mar0x/midi_router/doc/midi_router-bom.xlsx

Sheet: x4
id | q | ref | desc | size | Vendor |  | Order info
 |  |  |  |  | URL | code | # | date | price | count | shipping | cost | cost per item
Top board
15 pF | 2 | C11 C12 | Кер.ЧИП конд. 15 пФ, C0G, 50В, 5% | 0805 | CC0805JRNPO9BN150 (https://www.terraelectronica.ru/product/355297) | #355297 (https://www.terraelectronica.ru/product/355297) | #07487681 (https://www.terraelectronica.ru/order/07487681) | 06.07.2021 | 0.54 | 20 |  | 10.80 | 1.08
0.1 uF | 8 | C1 C2 C3 C4 C5 C6 C7 C8 | Кер.ЧИП конд. 0.1 мкФ, X7R, 50В, 10% | 0805 | CL21B104KBCNNNC (https://www.terraelectronica.ru/product/817075) | #817075 (https://www.terraelectronica.ru/product/817075) | #07487681 (https://www.terraelectronica.ru/order/07487681) | 06.07.2021 | 0.47 | 100 |  | 47.00 | 3.76
BAS316 | 4 | D1 D2 D3 D4 | Диод импульсный | SOD-323 | BAS316 TP (https://www.terraelectronica.ru/product/663682) | #663682 (https://www.terraelectronica.ru/product/663682) | #07487681 (https://www.terraelectronica.ru/order/07487681) | 06.07.2021 | 0.88 | 40 |  | 35.20 | 3.52
L-13YD | 5 | D5 D7 D9 D11 D13 | Светодиод жёлтый |  | L-13YD (https://www.terraelectronica.ru/product/307869) | #307869 (https://www.terraelectronica.ru/product/307869) | #07487681 (https://www.terraelectronica.ru/order/07487681) | 06.07.2021 | 5.4 | 50 |  | 270.00 | 27.00
L-13GD | 5 | D6 D8 D10 D12 D14 | Светодиод зелёный |  | L-13GD (https://www.terraelectronica.ru/product/307956) | #307956 (https://www.terraelectronica.ru/product/307956) | #07671493 (https://www.terraelectronica.ru/order/07671493) | 08.11.2021 | 5 | 50 |  | 250.00 | 25.00
L-13ID | 1 | D15 | Светодиод красный |  | L-13ID (https://www.terraelectronica.ru/product/307856) | #307856 (https://www.terraelectronica.ru/product/307856) | #07487681 (https://www.terraelectronica.ru/order/07487681) | 06.07.2021 | 5.1 | 10 |  | 51.00 | 5.10
 | 1 | J1 | PinSocket 2x5 |  |  | #33022627806 (https://www.aliexpress.ru/item/33022627806.html) | #5010848944632510 (https://trade.aliexpress.ru/order_detail.htm?orderId=5010848944632510&orderSource=GlobalTrade) | 12.06.2021 | 19.392 | 10 | 300.49 | 494.41 | 49.44
DS1013-06SSiB1-B-0 | 1 | J2 | IDC Header 2x3 |  | BH-06 (https://www.chipdip.ru/product/idc-06ms-bh-06) | #9000058155 (https://www.chipdip.ru/product/idc-06ms-bh-06) | #7174515 (https://www.chipdip.ru/order/detail/7174515) | 01.07.2021 | 10 | 10 |  | 100.00 | 10.00
470 | 15 | R1 R2 R3 R4 R6 R7 R8 R9 R10 R11 R12 R13 R14 R15 R16 | Резистор 470 Ом | 0805 | CR-05JL7--470R (https://www.terraelectronica.ru/product/2782454) | #2782454 (https://www.terraelectronica.ru/product/2782454) | #07487681 (https://www.terraelectronica.ru/order/07487681) | 06.07.2021 | 0.12 | 150 |  | 18.00 | 1.80
100 | 1 | R17 | Резистор 100 Ом | 0805
10 kOhm | 2 | R5 R18 | Резистор 10 кОм | 0805 | CR-05FL7---10K (https://www.terraelectronica.ru/product/2782222) | #2782222 (https://www.terraelectronica.ru/product/2782222) | #07655639 (https://www.terraelectronica.ru/order/07655639) | 25.10.2021 | 0.14 | 20 |  | 2.80 | 0.28
 | 1 | SW1 | Кнопка |  | KLS7-TS6606-8.0-180 (https://www.terraelectronica.ru/product/2177592) | #2177592 (https://www.terraelectronica.ru/product/2177592) | #07655639 (https://www.terraelectronica.ru/order/07655639) | 25.10.2021 | 2.3 | 10 |  | 23.00 | 2.30
74HCT541 | 2 | U2 U3 | Буферный элемент x8 | TSSOP-20 | MM74HCT541MTCX (https://www.chipdip.ru/product/mm74hct541mtcx) | #9000119229 (https://www.chipdip.ru/product/mm74hct541mtcx) | #7174515 (https://www.chipdip.ru/order/detail/7174515) | 01.07.2021 | 10.1 | 20 |  | 202.00 | 20.20
~~HCPL2730~~ | ~~0~~ | ~~U1 U4~~ | ~~Оптопара~~ | ~~DIP-8~~ | ~~HCPL-2730~~ (https://www.aliexpress.ru/item/32906296742.html) | ~~#32906296742~~ (https://www.aliexpress.ru/item/32906296742.html) | ~~#5011970852262510~~ (https://trade.aliexpress.ru/order_detail.htm?orderId=5011970852262510&orderSource=GlobalTrade) | ~~01.07.2021~~ | ~~17.94~~ | ~~40~~ | ~~190~~ | ~~907.60~~ | ~~0.00~~
HCPL2631 | 2 | U1 U4 | Оптопара | DIP-8 | HCPL-2631 (https://aliexpress.ru/item/33034209043.html) |  | #5015224573612510 (https://trade.aliexpress.ru/order_detail.htm?orderId=5015224573612510&orderSource=GlobalTrade) | 26.11.2021 | 8.221666667 | 60 | 196.54 | 689.84 | 22.99
ATxmega32A4U-AU | 1 | U5 | Микроконтроллер | TQFP-44 |  | #4000592649273 (https://www.aliexpress.ru/item/4000592649273.html) | #5010170738742510 (https://trade.aliexpress.ru/order_detail.htm?orderId=5010170738742510&orderSource=GlobalTrade) | 02.06.2021 | 149.11 | 5 | 317.53 | 1063.08 | 212.62
HC-49SD | 1 | Y1 | Кварцевый резонатор 16MHz |  | 12.88131 (https://www.terraelectronica.ru/product/219381) | #219381 (https://www.terraelectronica.ru/product/219381) | #07487681 (https://www.terraelectronica.ru/order/07487681) | 06.07.2021 | 11 | 10 |  | 110.00 | 11.00
Socket board
10 nF | 1 | C1 | Кер.ЧИП конд. 10 нФ, X7R, 100В, 10% | 0805 | CL21B103KCANNNC (https://www.terraelectronica.ru/product/863513) | #863513 (https://www.terraelectronica.ru/product/863513) | #07487681 (https://www.terraelectronica.ru/order/07487681) | 06.07.2021 | 0.4 | 100 |  | 40.00 | 0.40
0.1 uF | 1 | C2 | Кер.ЧИП конд. 0.1 мкФ, X7R, 50В, 10% | 0805 | CL21B104KBCNNNC (https://www.terraelectronica.ru/product/817075) | #817075 (https://www.terraelectronica.ru/product/817075) | #07487681 (https://www.terraelectronica.ru/order/07487681) | 06.07.2021 | 0.47 | 100 |  | 47.00 | 0.47
10 uF | 1 | C3 |  | 0805 | CL21A106KOQNNNG (https://www.terraelectronica.ru/product/863492) | #863492 (https://www.terraelectronica.ru/product/863492) | #07487681 (https://www.terraelectronica.ru/order/07487681) | 06.07.2021 | 0.86 | 100 |  | 86.00 | 0.86
MF-MSMF050-2 | 1 | F1 | Fuse | 1812 | MF-MSMF050-2 (https://www.terraelectronica.ru/product/186713) | #186713 (https://www.terraelectronica.ru/product/186713) | #07487681 (https://www.terraelectronica.ru/order/07487681) | 06.07.2021 | 3.2 | 10 |  | 32.00 | 3.20
 | 0.25 | J1 | PinHeader 2x5 |  | PLH-40 (https://www.chipdip.ru/product/plh-40) | #34079 (https://www.chipdip.ru/product/plh-40) | #7174515 (https://www.chipdip.ru/order/detail/7174515) | 01.07.2021 | 45 | 5 |  | 225.00 | 11.25
DS-5-01 | 8 | J2 J3 J4 J5 J6 J7 J10 J11 | MIDI разъём | DIN-5 | DS-5-01 (https://www.aliexpress.ru/item/1005002434565701.html) | #1005002434565701 (https://www.aliexpress.ru/item/1005002434565701.html) | #5009893661922510 (https://trade.aliexpress.ru/order_detail.htm?orderId=5009893661922510&orderSource=GlobalTrade) | 18.04.2021 | 7.376 | 100 | 775.44 | 1513.04 | 121.04
USB-B | 1 | J8 | Разъём USB-B |  | DS1099-WN0-FE (https://www.terraelectronica.ru/product/3638121) | #3638121 (https://www.terraelectronica.ru/product/3638121) | #07487681 (https://www.terraelectronica.ru/order/07487681) | 06.07.2021 | 6 | 10 |  | 60.00 | 6.00
220 Ohm | 12 | R2 R3 R4 R5 R7 R9 R10 R11 R12 R13 R22 R23 | Резистор 220 Ом | 0805 | CR-05JL7--220R (https://www.terraelectronica.ru/product/2782412) | #2782412 (https://www.terraelectronica.ru/product/2782412) | #07487681 (https://www.terraelectronica.ru/order/07487681) | 06.07.2021 | 0.12 | 120 |  | 14.40 | 1.44
USBLC6-2SC6 | 1 | U1 | Защита интерфейса USB | SOT-23-6 | USBLC6-2SC6 (https://www.terraelectronica.ru/product/244787) | #244787 (https://www.terraelectronica.ru/product/244787) | #07487681 (https://www.terraelectronica.ru/order/07487681) | 06.07.2021 | 6.3 | 10 |  | 63.00 | 6.30
LD1117S33TR_SOT223 | 1 | U2 | Регулятор напряжения | SOT-223 | LD1117S33TR (https://www.terraelectronica.ru/product/208059) | #208059 (https://www.terraelectronica.ru/product/208059) | #07655639 (https://www.terraelectronica.ru/order/07655639) | 25.10.2021 | 10.8 | 20 |  | 216.00 | 10.80
PCB | 1 |  |  |  |  |  |  |  | 75.724 | 10 | 729.22 | 1486.46 | 148.65
Box | 70 |  | Корпус, масса в граммах |  |  |  |  |  | 5.866666667 | 750 |  | 4400.00 | 410.67
Стойки | 2 |  | Cтойки латунные 18мм | PCHSS-18 | PCHSS-18 (https://aliexpress.ru/item/1005002565104460.html) |  | #5016317462462510 (https://trade.aliexpress.ru/order_detail.htm?orderId=5016317462462510&orderSource=GlobalTrade) | 14.01.2022 | 15.9 | 20 |  | 318.00 | 31.80
Винт М3 | 4 |  | Винт М3x6мм | M3x6 | M3x6 A2 304 (https://aliexpress.ru/item/4000341151320.html) |  | #5016333550992510 (https://trade.aliexpress.ru/order_detail.htm?orderId=5016333550992510&orderSource=GlobalTrade) | 14.01.2022 | 1.6434 | 100 |  | 164.34 | 6.57
Саморез | 4 |  | Cаморез 2.6x12mm | 2.6x12 | 2.6x12mm Pan Head (https://aliexpress.ru/item/1005002113013637.html) |  | #5012498625982510 (https://trade.aliexpress.ru/order_detail.htm?orderId=5012498625982510&orderSource=GlobalTrade) | 03.08.2021 | 1.4508 | 100 |  | 145.08 | 5.80
Шильдик | 1 |  |  |  |  |  |  |  | 10 | 1 |  | 10.00 | 10.00
Итого |  |  |  |  |  |  |  |  |  |  |  |  | 1171.34

Sheet: x7
id | q | ref | desc | size | Vendor |  | Order info
 |  |  |  |  | URL | code | # | date | price | count | shipping | cost | cost per item
15 pF | 2 | C11 C12 | Кер.ЧИП конд. 15 пФ, C0G, 50В, 5% | 0805 | CC0805JRNPO9BN150 (https://www.terraelectronica.ru/product/355297) | #355297 (https://www.terraelectronica.ru/product/355297) | #07732648 (https://www.terraelectronica.ru/order/07732648) | 15.12.2021 | 0.59 | 20 |  | 11.80 | 1.18
0.01 uF | 1 | C14 | Кер.ЧИП конд. 0.01 мкФ | 0805 | CL21B103KCANNNC (https://www.terraelectronica.ru/product/863513) | #863513 (https://www.terraelectronica.ru/product/863513) | #07655639 (https://www.terraelectronica.ru/order/07655639) | 25.10.2021 | 0.38 | 10 |  | 3.80 | 0.38
10 uF | 1 | C6 | Кер.ЧИП конд. 10 мкФ | 0805 | CL21A106KOQNNNE (https://www.terraelectronica.ru/product/863491) | #863491 (https://www.terraelectronica.ru/product/863491) | #07655639 (https://www.terraelectronica.ru/order/07655639) | 25.10.2021 | 0.82 | 10 |  | 8.20 | 0.82
0.1 uF | 18 | C1 C2 C3 C4 C5 C7 C8 C9 C10 C13 C15 C16 C17 C18 C19 C20 C21 C22 | Кер.ЧИП конд. 0.1 мкФ, X7R, 50В, 10% | 0805 | CL21F104ZBCNNNC (https://www.terraelectronica.ru/product/863708) | #863708 (https://www.terraelectronica.ru/product/863708) | #07655639 (https://www.terraelectronica.ru/order/07655639) | 25.10.2021 | 0.5 | 200 |  | 100.00 | 9.00
BAS316 | 7 | D1 D4 D13 D17 D22 D23 D24 | Диод импульсный | SOD-323 | BAS316.115 (https://www.terraelectronica.ru/product/241389) | #241389 (https://www.terraelectronica.ru/product/241389) | #07655639 (https://www.terraelectronica.ru/order/07655639) | 25.10.2021 | 1.2 | 70 |  | 84.00 | 8.40
L-383YD | 8 | D2 D3 D5 D6 D7 D8 D9 D19 | Светодиод жёлтый |  | L-383YDT (https://www.terraelectronica.ru/product/25499) | #25499 (https://www.terraelectronica.ru/product/25499) | #07655639 (https://www.terraelectronica.ru/order/07655639) | 25.10.2021 | 5.2 | 80 |  | 416.00 | 41.60
L-383GD | 8 | D10 D11 D12 D14 D15 D16 D18 D21 | Светодиод зелёный |  | L-383GDT (https://www.terraelectronica.ru/product/25298) | #25298 (https://www.terraelectronica.ru/product/25298) | #07655639 (https://www.terraelectronica.ru/order/07655639) | 25.10.2021 | 5.3 | 80 |  | 424.00 | 42.40
L-383ID | 1 | D20 | Светодиод красный |  | L-383IDT (https://www.terraelectronica.ru/product/314765) | #314765 (https://www.terraelectronica.ru/product/314765) | #07655639 (https://www.terraelectronica.ru/order/07655639) | 25.10.2021 | 4.9 | 10 |  | 49.00 | 4.90
MF-MSMF050-2 | 1 | F1 |  | 1812 | MF-MSMF050-2 (https://www.terraelectronica.ru/product/186713) | #186713 (https://www.terraelectronica.ru/product/186713) | #07707963 (https://www.terraelectronica.ru/order/07707963) | 30.11.2021 | 3.3 | 10 |  | 33.00 | 3.30
DS1013-06SSiB1-B-0 | 1 | J11 | IDC Header 2x3 |  | DS1013-06SSiB1-B-0 (https://www.terraelectronica.ru/product/2739747) | #2739747 (https://www.terraelectronica.ru/product/2739747) | #07655639 (https://www.terraelectronica.ru/order/07655639) | 25.10.2021 | 3.8 | 10 |  | 38.00 | 3.80
220 | 21 | R1 R4 R5 R9 R12 R13 R18 R20 R21 R27 R29 R30 R35 R36 R37 R40 R41 R42 R45 R46 R47 | Резистор 220 Ом | 0805 | RC0805FR-07220RL (https://www.terraelectronica.ru/product/432087) | #432087 (https://www.terraelectronica.ru/product/432087) | #07655639 (https://www.terraelectronica.ru/order/07655639) | 25.10.2021 | 0.18 | 200 |  | 36.00 | 3.78
470 | 24 | R2 R3 R6 R7 R8 R10 R11 R14 R15 R16 R17 R19 R22 R23 R24 R25 R26 R28 R31 R32 R34 R38 R39 R48 | Резистор 470 Ом | 0805 | CR-05FL7--470R (https://www.terraelectronica.ru/product/2782319) | #2782319 (https://www.terraelectronica.ru/product/2782319) | #07655639 (https://www.terraelectronica.ru/order/07655639) | 25.10.2021 | 0.12 | 240 |  | 28.80 | 2.88
100 | 1 | R44 | Резистор 100 Ом | 0805 | RC0805JR-07100RL (https://www.terraelectronica.ru/product/353447) | #353447 (https://www.terraelectronica.ru/product/353447) | #07655639 (https://www.terraelectronica.ru/order/07655639) | 25.10.2021 | 0.14 | 10 |  | 1.40 | 0.14
10 kOhm | 2 | R33 R43 | Резистор 10 кОм | 0805 | CR-05FL7---10K (https://www.terraelectronica.ru/product/2782222) | #2782222 (https://www.terraelectronica.ru/product/2782222) | #07655639 (https://www.terraelectronica.ru/order/07655639) | 25.10.2021 | 0.14 | 20 |  | 2.80 | 0.28
100 kOhm | 1 | R49 | Резистор 100 кОм | 0805 | CR-05JL7--100K (https://www.terraelectronica.ru/product/2782368) | #2782368 (https://www.terraelectronica.ru/product/2782368) | #07655639 (https://www.terraelectronica.ru/order/07655639) | 25.10.2021 | 0.11 | 10 |  | 1.10 | 0.11
 | 1 | SW1 | Кнопка |  | KLS7-TS6606-5.0-180 (https://www.terraelectronica.ru/product/1352789) | #1352789 (https://www.terraelectronica.ru/product/1352789) | #07655639 (https://www.terraelectronica.ru/order/07655639) | 25.10.2021 | 2.3 | 10 |  | 23.00 | 2.30
74HCT541 | 3 | U1 U3 U6 | Буферный элемент x8 | TSSOP-20 | MM74HCT541MTCX (https://www.chipdip.ru/product/mm74hct541mtcx) | #9000119229 (https://www.chipdip.ru/product/mm74hct541mtcx) | #7670264 (https://www.chipdip.ru/order/detail/7670264) | 23.10.2021 | 33.9 | 27 | 253 | 1168.30 | 129.81
~~HCPL2730~~ | ~~0~~ | ~~U2 U4 U7 U9~~ | ~~Оптопара~~ | ~~DIP-8~~ | ~~HCPL-2730~~ (https://www.aliexpress.ru/item/32906296742.html) | ~~#32906296742~~ (https://www.aliexpress.ru/item/32906296742.html) | ~~#5011970852262510~~ (https://trade.aliexpress.ru/order_detail.htm?orderId=5011970852262510&orderSource=GlobalTrade) | ~~01.07.2021~~ | ~~17.94~~ | ~~40~~ | ~~190~~ | ~~907.60~~ | ~~0.00~~
HCPL2631 | 4 | U2 U4 U7 U9 | Оптопара | DIP-8 | HCPL-2631 (https://aliexpress.ru/item/33034209043.html) |  | #5015224573612510 (https://trade.aliexpress.ru/order_detail.htm?orderId=5015224573612510&orderSource=GlobalTrade) | 26.11.2021 | 8.221666667 | 60 | 196.54 | 689.84 | 45.99
ATxmega128A1U-AU | 1 | U8 | Микроконтроллер | TQFP-100 | ATxmega128A1U-AU (https://www.chipdip.ru/product/atxmega128a1u-au) | #9000183845 (https://www.chipdip.ru/product/atxmega128a1u-au) | #7292866 (https://www.chipdip.ru/order/detail/7292866) | 04.08.2021 | 1650 | 10 |  | 16500.00 | 1650.00
HC-49SD | 1 | Y1 | Кварцевый резонатор 16MHz |  | 12.88009 (https://www.terraelectronica.ru/product/42598) | #42598 (https://www.terraelectronica.ru/product/42598) | #07655639 (https://www.terraelectronica.ru/order/07655639) | 25.10.2021 | 18.7 | 10 |  | 187.00 | 18.70
LD1117S33TR_SOT223 | 1 | U5 | Регулятор напряжения | SOT-223 | LD1117S33TR (https://www.terraelectronica.ru/product/208059) | #208059 (https://www.terraelectronica.ru/product/208059) | #07655639 (https://www.terraelectronica.ru/order/07655639) | 25.10.2021 | 10.8 | 20 |  | 216.00 | 10.80
USB-B | 1 | J16 | Разъём USB-B |  | DS1099-WN0-FE (https://www.terraelectronica.ru/product/3638121) | #3638121 (https://www.terraelectronica.ru/product/3638121) | #07655639 (https://www.terraelectronica.ru/order/07655639) | 25.10.2021 | 5.7 | 10 |  | 57.00 | 5.70
USBLC6-2SC6 | 1 | U10 | Защита интерфейса USB | SOT-23-6 | USBLC6-2SC6 (https://www.terraelectronica.ru/product/244787) | #244787 (https://www.terraelectronica.ru/product/244787) | #07655639 (https://www.terraelectronica.ru/order/07655639) | 25.10.2021 | 5.3 | 10 |  | 53.00 | 5.30
 | 14 | J1 J2 J3 J4 J5 J6 J7 J8 J9 J10 J12 J13 J14 J15 | MIDI разъём | DIN-5 | DS-5-01 (https://www.aliexpress.ru/item/32402564814.html) | #32402564814 (https://www.aliexpress.ru/item/32402564814.html) | #5014441743802510 (https://trade.aliexpress.ru/order_detail.htm?orderId=5014441743802510&orderSource=GlobalTrade) | 03.11.2021 | 6.865 | 120 | 622 | 1445.80 | 168.68
 | ~~0~~ |  | ~~Гнездо на плату 2.54мм 1х2 прямое~~ |  | ~~PBS-2 (DS1023-1x2)~~ (https://www.chipdip.ru/product/pbs2) | ~~#44684~~ (https://www.chipdip.ru/product/pbs2) | ~~#7292866~~ (https://www.chipdip.ru/order/detail/7292866) | ~~04.08.2021~~ | ~~5~~ | ~~20~~ |  | ~~100.00~~ | ~~0.00~~
DS1023-1x2S21 | 17 |  | Гнездо на плату 2.54мм 1х2 прямое |  | DS1023-1x2S21 (https://www.terraelectronica.ru/product/2784510) | #2784510 (https://www.terraelectronica.ru/product/2784510) | #07769607 (https://www.terraelectronica.ru/order/07769607) | 18.11.2022 | 1.3 | 120 |  | 156.00 | 22.10
PCB | 1 |  |  |  |  |  | W202107291840866 (https://jlcpcb.com/orderDetails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) | 29.07.2021 | 105.373 | 10 | 1021.53 | 2075.26 | 207.53
Box | 72 |  | Корпус, масса в граммах |  |  |  |  |  | 5.866666667 | 750 |  | 4400.00 | 422.40
Cover | 42 |  | Крышка корпуса, масса в граммах |  |  |  |  |  | 5.866666667 | 750 |  | 4400.00 | 246.40
Саморез | 6 |  | Cаморез 2.6x12mm | 2.6x12 | 2.6x12mm Pan Head (https://aliexpress.ru/item/1005002113013637.html) |  | #5012498625982510 (https://trade.aliexpress.ru/order_detail.htm?orderId=5012498625982510&orderSource=GlobalTrade) | 03.08.2021 | 1.4508 | 100 |  | 145.08 | 8.70
Шильдик | 1 |  |  |  |  |  |  |  | 10 | 1 |  | 10.00 | 10.00
Итого |  |  |  |  |  |  |  |  |  |  |  |  | 3077.38

Sheet: x7-rack
Ref | Qnty | Value | Footprint | Description | Vendor
C1, C2, C3, C4, C5, C6, C7, C8, C9, C10, C11, C1.3, C1.4, C10.1, C10.2, C10.3, C10.4, C10.5, C10.6, C10.7, C10.8, C10.9, | 22 | 0.1u | Capacitor_SMD:C_0805_2012Metric | Unpolarized capacitor, small symbol
C2.1, C2.2, C2.3, C2.4, C2.5, C2.6, C2.7, C2.8, C2.9, C12, C19.1, C19.2, C19.3, C19.4, C19.5, C19.6, | 16 | 0 Ohm | Resistor_SMD:R_0805_2012Metric | Unpolarized capacitor, small symbol
C11.1, | 1 | 10u | Capacitor_SMD:C_0805_2012Metric | Unpolarized capacitor, small symbol
C15, C16, | 2 | 15p | Capacitor_SMD:C_0805_2012Metric | Unpolarized capacitor, small symbol
D1, D2, D3, D4, D5, D6, D7, D1.1, D1.2, | 9 | BAS316.115 | Diode_SMD:D_SOD-323_HandSoldering | Diode, small symbol
F1, | 1 | MF-MSMF050-2 | Fuse:Fuse_1812_4532Metric | Resettable fuse, polymeric positive temperature coefficient, small symbol
J1, J2, J3, J4, J5, J6, J7, J8, J9, J10, J11, J12, J13, J14, J1.2, J8.2, | 16 | DIN-5_180degree | lib:DIN5MIDI-OOTDTY | 5-pin DIN connector (5-pin DIN-5 stereo)
J15, | 1 | USB_B | Connector_USB:USB_B_OST_USB-B1HSxx_Horizontal | USB Type B connector
J16, | 1 | DS1013-06SSiB1-B-0 | Connector_IDC:IDC-Header_2x03_P2.54mm_Vertical | Generic connector, double row, 02x03, odd/even pin numbering scheme (row 1 odd numbers, row 2 even numbers), script generated (kicad-library-utils/schlib/autogen/connector/)
J17, | 1 | Conn_01x04_Male | Connector_JST:JST_EH_B4B-EH-A_1x04_P2.50mm_Vertical | Generic connector, single row, 01x04, script generated (kicad-library-utils/schlib/autogen/connector/)
J18, J18.2, | 2 | Conn_02x04_Odd_Even | Connector_IDC:IDC-Header_2x04_P2.54mm_Vertical | Generic connector, double row, 02x04, odd/even pin numbering scheme (row 1 odd numbers, row 2 even numbers), script generated (kicad-library-utils/schlib/autogen/connector/)
J19, J19.2, | 2 | Conn_02x15_Odd_Even | Connector_IDC:IDC-Header_2x15_P2.54mm_Vertical | Generic connector, double row, 02x15, odd/even pin numbering scheme (row 1 odd numbers, row 2 even numbers), script generated (kicad-library-utils/schlib/autogen/connector/)
J20, | 1 | Conn_01x04_Male | Connector_PinHeader_2.54mm:PinHeader_1x04_P2.54mm_Vertical | Generic connector, single row, 01x04, script generated (kicad-library-utils/schlib/autogen/connector/)
R1, R2, R3, R4, R5, R6, R7, R8, R1.1, R1.4, R1.5, R1.6, R1.8, R2.1, R3.1, R4.1, R5.1, R6.1, R7.1, R8.1, R8.2, R9.1, R9.2, R10.1, R10.2, R11.1, R11.2, R12.1, R12.2, R13.1, R13.2, R14.1, R14.2, R18.1, R18.2, | 35 | 220 Ohm | Resistor_SMD:R_0805_2012Metric | Resistor
R1.2, R1.10, R18, | 3 | 100k | Resistor_SMD:R_0805_2012Metric | Resistor
R1.9, | 1 | 1k | Resistor_SMD:R_0805_2012Metric | Resistor
R16, R17, | 2 | 10k | Resistor_SMD:R_0805_2012Metric | Resistor
U1, U2, U3, U4, U5, | 5 | HCPL-2631 | Package_DIP:DIP-8_W7.62mm | Dual High Speed HCMOS/LSTTL/TTL Compatible Optocoupler, dV/dt 1000/us, VCM 1000, -0.5V to 7V VCC, DIP-8
U1.3, U1.4, | 2 | 74AHC1G125 | Package_TO_SOT_SMD:SOT-23-5 | Single Buffer Gate Tri-State, Low-Voltage CMOS
U6, U7, U8, U9, | 4 | 74HCT541 | Package_SO:TSSOP-20_4.4x6.5mm_P0.65mm | 8-bit Buffer/Line Driver 3-state outputs
U10, | 1 | ATxmega128A1U-A | Package_QFP:TQFP-100_14x14mm_P0.5mm | 32MHz, 128kB Flash, 8kB Boot, 8kB SRAM, 2kB EEPROM, JTAG, USB, TQFP-100
U11, | 1 | LD1117S33TR_SOT223 | Package_TO_SOT_SMD:SOT-223-3_TabPin2 | 800mA Fixed Low Drop Positive Voltage Regulator, Fixed Output 3.3V, SOT-223
U12, | 1 | USBLC6-2SC6 | Package_TO_SOT_SMD:SOT-23-6 | Very low capacitance ESD protection diode, 2 data-line, SOT-23-6
Y1, | 1 | 16MHz | Crystal:Crystal_SMD_HC49-SD | Two pin crystal, small symbol
D19.1, D19.2, D19.3, D19.4, D19.5, D19.6, D19.7, D19.8, D19.9, D19.10, D19.11, D19.12, D19.13, D19.14, D19.15, D19.16, D19.18, D19.19, D19.20, D19.21, D19.22, | 21 | LED | LED_THT:LED_Rectangular_W5.0mm_H2.0mm | Light emitting diode
R19.1, R19.2, R19.3, R19.4, R19.5, R19.6, R19.7, R19.8, R19.9, R19.10, R19.11, R19.12, R19.13, R19.14, R19.15, R19.16, R19.17, R19.18, R19.19, R19.20, R19.21, R19.22, | 22 | 470 Ohm | Resistor_SMD:R_0805_2012Metric | Resistor
SW19.1, | 1 | SW_Push_LED | lib:SW_PUSH_6mm | Push button switch with LED, generic
case | 1

Sheet: BOM
id | desc | size | Vendor | Order info
 |  |  | URL | # | date | price | count | shipping | cost | cost per item
15 pF | Кер.ЧИП конд. 15 пФ, C0G, 50В, 5% | 0805 | CC0805JRNPO9BN150 (https://www.terraelectronica.ru/product/355297) | #07863451 | 2022-03-22 | 1 | 100 |  | 100.00 | 1.00
0.01 uF | Кер.ЧИП конд. 0.01 мкФ | 0805 | CL21B103KCANNNC (https://www.terraelectronica.ru/product/863513) | #07655639 (https://www.terraelectronica.ru/order/07655639) | 25.10.2021 | 0.38 | 10 |  | 3.80 | 0.38
10 uF | Кер.ЧИП конд. 10 мкФ | 0805 | CL21A106KOQNNNE (https://www.terraelectronica.ru/product/863491) | #07655639 (https://www.terraelectronica.ru/order/07655639) | 25.10.2021 | 0.82 | 10 |  | 8.20 | 0.82
0.1 uF | Кер.ЧИП конд. 0.1 мкФ, X7R, 50В, 10% | 0805 | CL21F104ZBCNNNC (https://www.terraelectronica.ru/product/863708) | #07655639 (https://www.terraelectronica.ru/order/07655639) | 25.10.2021 | 0.5 | 200 |  | 100.00 | 0.50
BAS316 | Диод импульсный | SOD-323 | BAS316.115 (https://www.terraelectronica.ru/product/241389) | #07655639 (https://www.terraelectronica.ru/order/07655639) | 25.10.2021 | 1.2 | 70 |  | 84.00 | 1.20
L-383YD | Светодиод жёлтый |  | L-383YDT (https://www.terraelectronica.ru/product/25499) | #07655639 (https://www.terraelectronica.ru/order/07655639) | 25.10.2021 | 5.2 | 80 |  | 416.00 | 5.20
L-383GD | Светодиод зелёный |  | L-383GDT (https://www.terraelectronica.ru/product/25298) | #07655639 (https://www.terraelectronica.ru/order/07655639) | 25.10.2021 | 5.3 | 80 |  | 424.00 | 5.30
L-383ID | Светодиод красный |  | L-383IDT (https://www.terraelectronica.ru/product/314765) | #07655639 (https://www.terraelectronica.ru/order/07655639) | 25.10.2021 | 4.9 | 10 |  | 49.00 | 4.90
L-13YD | Светодиод жёлтый |  | L-13YD (https://www.terraelectronica.ru/product/307869) | #07863451 (https://www.terraelectronica.ru/order/07863451) | 29.03.2022 | 9.7 | 50 |  | 485.00 | 9.70
L-13GD | Светодиод зелёный |  | L-13GD (https://www.chipdip.ru/product/l-13gd) | #8341104 (https://www.chipdip.ru/order/detail/8341104) | 22.03.2022 | 29 | 70 |  | 2030.00 | 29.00
L-13ID | Светодиод красный |  | L-13ID (https://www.terraelectronica.ru/product/307856) | #07863451 (https://www.terraelectronica.ru/order/07863451) | 29.03.2022 | 9.8 | 30 |  | 294.00 | 9.80
BAS316 | Диод импульсный | SOD-323 | BAS316,115 (https://www.chipdip.ru/product/bas316) | #5180376 (https://www.chipdip.ru/order/item/5180376) | 06.07.2022 | 13.8 | 200 |  | 2760.00 | 13.80
MF-MSMF050-2 | Предохранитель самовосстанавливающийся SMD | 1812 | MF-MSMF050-2 (https://www.terraelectronica.ru/product/186713) | #07707963 (https://www.terraelectronica.ru/order/07707963) | 30.11.2021 | 3.3 | 10 |  | 33.00 | 3.30
100 | Резистор 100 Ом | 0805 | RC0805JR-07100RL (https://www.terraelectronica.ru/product/353447) | #07655639 (https://www.terraelectronica.ru/order/07655639) | 25.10.2021 | 0.14 | 10 |  | 1.40 | 0.14
220 | Резистор 220 Ом | 0805 | RC0805FR-07220RL (https://www.terraelectronica.ru/product/432087) | #07655639 (https://www.terraelectronica.ru/order/07655639) | 25.10.2021 | 0.18 | 200 |  | 36.00 | 0.18
470 | Резистор 470 Ом | 0805 | CR-05FL7--470R (https://www.terraelectronica.ru/product/2782319) | #07655639 (https://www.terraelectronica.ru/order/07655639) | 25.10.2021 | 0.12 | 240 |  | 28.80 | 0.12
10 kOhm | Резистор 10 кОм | 0805 | CR-05FL7---10K (https://www.terraelectronica.ru/product/2782222) | #07655639 (https://www.terraelectronica.ru/order/07655639) | 25.10.2021 | 0.14 | 20 |  | 2.80 | 0.14
100 kOhm | Резистор 100 кОм | 0805 | CR-05JL7--100K (https://www.terraelectronica.ru/product/2782368) | #07655639 (https://www.terraelectronica.ru/order/07655639) | 25.10.2021 | 0.11 | 10 |  | 1.10 | 0.11
KLS7-TS6606-5.0-180 | Кнопка угловая 5 мм |  | KLS7-TS6606-5.0-180 (https://www.terraelectronica.ru/product/1352789) | #07655639 (https://www.terraelectronica.ru/order/07655639) | 25.10.2021 | 2.3 | 10 |  | 23.00 | 2.30
74HCT541 | Буферный элемент x8 | TSSOP-20 | MM74HCT541MTCX (https://www.chipdip.ru/product/mm74hct541mtcx) | #7670264 (https://www.chipdip.ru/order/detail/7670264) | 23.10.2021 | 33.9 | 27 | 253 | 1168.30 | 43.27
~~HCPL2730~~ | ~~Оптопара~~ | ~~DIP-8~~ | ~~HCPL-2730~~ (https://www.aliexpress.ru/item/32906296742.html) | ~~#5011970852262510~~ (https://trade.aliexpress.ru/order_detail.htm?orderId=5011970852262510&orderSource=GlobalTrade) | ~~01.07.2021~~ | ~~17.94~~ | ~~40~~ | ~~190~~ | ~~907.60~~ | 22.69
HCPL2631 | Оптопара | DIP-8 | HCPL-2631 (https://aliexpress.ru/item/33034209043.html) | #5015224573612510 (https://trade.aliexpress.ru/order_detail.htm?orderId=5015224573612510&orderSource=GlobalTrade) | 26.11.2021 | 8.221666667 | 60 | 196.54 | 689.84 | 11.50
ATxmega32A4U-AU | Микроконтроллер | TQFP-44
ATxmega128A1U-AU | Микроконтроллер | TQFP-100 | ATxmega128A1U-AU (https://www.chipdip.ru/product/atxmega128a1u-au) | #7292866 (https://www.chipdip.ru/order/detail/7292866) | 04.08.2021 | 1650 | 10 |  | 16500.00 | 1650.00
HC-49SD | Кварцевый резонатор 16MHz |  | 12.88009 (https://www.terraelectronica.ru/product/42598) | #07655639 (https://www.terraelectronica.ru/order/07655639) | 25.10.2021 | 18.7 | 10 |  | 187.00 | 18.70
USBLC6-2SC6 | Защита интерфейса USB | SOT-23-6 | USBLC6-2SC6 (https://www.terraelectronica.ru/product/244787) | #07655639 (https://www.terraelectronica.ru/order/07655639) | 25.10.2021 | 5.3 | 10 |  | 53.00 | 5.30
LD1117S33TR | Регулятор напряжения | SOT-223 | LD1117S33TR (https://www.terraelectronica.ru/product/208059) | #07655639 (https://www.terraelectronica.ru/order/07655639) | 25.10.2021 | 10.8 | 20 |  | 216.00 | 10.80
 | PinSocket 2x10 SMD 2.54
 | PinHeader 2x10 2.54
DS1013-06SSiB1-B-0 | IDC Header 2x3 |  | DS1013-06SSiB1-B-0 (https://www.terraelectronica.ru/product/2739747) | #07655639 (https://www.terraelectronica.ru/order/07655639) | 25.10.2021 | 3.8 | 10 |  | 38.00 | 3.80
USB-B | Разъём USB-B |  | DS1099-WN0-FE (https://www.terraelectronica.ru/product/3638121) | #07655639 (https://www.terraelectronica.ru/order/07655639) | 25.10.2021 | 5.7 | 10 |  | 57.00 | 5.70
DIN5-DS-5-01 | MIDI разъём | DIN-5 | DS-5-01 (https://www.aliexpress.ru/item/32402564814.html) | #5014441743802510 (https://trade.aliexpress.ru/order_detail.htm?orderId=5014441743802510&orderSource=GlobalTrade) | 03.11.2021 | 6.865 | 120 | 622 | 1445.80 | 12.05
 | ~~Гнездо на плату 2.54мм 1х2 прямое~~ |  | ~~PBS-2 (DS1023-1x2)~~ (https://www.chipdip.ru/product/pbs2) | ~~#7292866~~ (https://www.chipdip.ru/order/detail/7292866) | ~~04.08.2021~~ | ~~5~~ | ~~20~~ |  | ~~100.00~~ | 5.00
DS1023-1x2S21 | Гнездо на плату 2.54мм 1х2 прямое |  | DS1023-1x2S21 (https://www.terraelectronica.ru/product/2784510) | #07769607 (https://www.terraelectronica.ru/order/07769607) | 18.11.2022 | 1.3 | 120 |  | 156.00 | 1.30
PCB x4
PCB x4 flat |  | 100x80 |  | #1210961 (https://service.rezonit.ru/orders/1210961) | 03.06.2022 | 735.996 | 10 |  | 7359.96 | 736.00
PCB x7 |  |  |  | W202107291840866 (https://jlcpcb.com/orderDetails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) | 29.07.2021 | 105.373 | 10 | 1021.53 | 2075.26 | 207.53
Box & Cover x4 | Корпус с крышкой, масса в граммах | 70 |  |  |  | 5.866666667 | 749 |  | 4394.13 | 410.67
Box & Cover x4 Flat | Корпус с крышкой, масса в граммах | 78 |  |  |  | 5.866666667 | 749 |  | 4394.13 | 457.60
Box x7 | Корпус, масса в граммах | 72 |  |  |  | 5.866666667 | 750 |  | 4400.00 | 422.40
Cover x7 | Крышка корпуса, масса в граммах | 42 |  |  |  | 5.866666667 | 750 |  | 4400.00 | 246.40
Винт М3x6 | Винт М3x6 мм
PCHSS-18 | Стойка латунная M3x18 мм
Саморез 2.3x12
Саморез 2.6x12 | Cаморез 2.6x12mm | 2.6x12 | 2.6x12mm Pan Head (https://aliexpress.ru/item/1005002113013637.html) | #5012498625982510 (https://trade.aliexpress.ru/order_detail.htm?orderId=5012498625982510&orderSource=GlobalTrade) | 03.08.2021 | 1.4508 | 100 |  | 145.08 | 1.45
Шильдик |  |  |  |  |  | 10 | 1 |  | 10.00 | 10.00

Sheet: Orders
name | q | vendor | order date | receive date | order id | price | shipping | payment | per item
PCB x4 | 10 | jlcpcb.com | 2021-04-14 |  | #Y33-2346369A #Y34-2346369A | 757.24 | 729.22 | 1486.46 | 148.646
DS-5-01 MIDI | 100 | aliexpress.com | 2021-04-18 |  | #5009893661922510 (https://trade.aliexpress.ru/order_detail.htm?orderId=5009893661922510&orderSource=GlobalTrade) | 737.58 | 785.44 | 1523.02 | 15.2302
ATxmega32a4u | 5 | aliexpress.com | 2021-05-05 |  | #5010170738742510 (https://trade.aliexpress.ru/order_detail.htm?orderId=5010170738742510&orderSource=GlobalTrade) | 745.53 | 317.53 | 1063.06 | 212.612
разъём 2x10 SMD | 10 | aliexpress.com | 2021-06-12 |  | #5010848944632510 (https://trade.aliexpress.ru/order_detail.htm?orderId=5010848944632510&orderSource=GlobalTrade) | 193.91 | 300.49 | 494.4 | 49.44
 | 15 | terraelectronica.ru | 2021-07-01 |  | #07487681 (https://www.terraelectronica.ru/order/07487681) | 2083.33 | 236 | 2319.33
 | 3 | chipdip.ru | 2021-07-01 |  | #7174515 (https://www.chipdip.ru/order/detail/7174515) | 527 | 138 | 665
PCB x7 | 10 | jlcpcb.com | 2021-07-29 |  | #Y35-2346369A | 1053.73 | 1021.53 | 2075.26 | 207.526
 | 5 | chipdip.ru | 2021-07-29 |  | #7292866 (https://www.chipdip.ru/order/detail/7292866) | 9910 | 138 | 10048
саморезы М2.6x12 | 100 | aliexpress.com | 2021-08-03 |  | #5012498625982510 (https://trade.aliexpress.ru/order_detail.htm?orderId=5012498625982510&orderSource=GlobalTrade) | 145.08 |  | 145.08 | 1.4508
 | 20 | terraelectronica.ru | 2021-10-22 |  | #07655639 (https://www.terraelectronica.ru/order/07655639) | 1762.7 | 297 | 2059.7
 | 2 | chipdip.ru | 2021-10-23 |  | #7670264 (https://www.chipdip.ru/order/detail/7670264) | 1235.3 | 253 | 1488.3
DS-5-01 MIDI | 120 | aliexpress.com | 2021-11-03 |  | #5014441743802510 (https://trade.aliexpress.ru/order_detail.htm?orderId=5014441743802510&orderSource=GlobalTrade) | 823.82 | 622.3 | 1446.12 | 12.051
HCPL-2631 | 60 | aliexpress.com | 2021-11-26 |  | #5015224573612510 (https://trade.aliexpress.ru/order_detail.htm?orderId=5015224573612510&orderSource=GlobalTrade) | 1183.88 | 196.54 | 1380.42 | 23.007
 | 15 | terraelectronica.ru | 2021-11-29 |  | #07707963 (https://www.terraelectronica.ru/order/07707963) | 1135.4 | 236 | 1371.4
винт М3x6 | 50 | aliexpress.com | 2022-01-14 |  | #5016333550992510 (https://trade.aliexpress.ru/order_detail.htm?orderId=5016333550992510&orderSource=GlobalTrade) | 164.34 |  | 164.34 | 3.2868
cтойка латунная PCHSS-18 | 20 | aliexpress.com | 2022-01-14 |  | #5016317462462510 (https://trade.aliexpress.ru/order_detail.htm?orderId=5016317462462510&orderSource=GlobalTrade) | 318 |  | 318 | 15.9
PCB splitter x6 | 10 | jlcpcb.com | 2022-02-01 |  | #Y31-2346369A | 387.29 | 549.18 | 936.47 | 93.647
DS-5-01 MIDI | 100 | aliexpress.com | 2022-02-01 |  | #5016623841712510 (https://trade.aliexpress.ru/order_detail.htm?orderId=5016623841712510&orderSource=GlobalTrade) | 797.1 | 590.3 | 1387.4 | 13.874
 |  | terraelectronica.ru | 2022-02-02 |  | #07796164 (https://www.terraelectronica.ru/order/07796164) | 505.44 | 236 | 741.44
 |  | terraelectronica.ru | 2022-02-25 |  | #07831475 (https://www.terraelectronica.ru/order/07831475) | 505.92 | 236 | 741.92
6N138M | 20 | aliexpress.com | 2022-03-05 |  | #5017385647722510 (https://trade.aliexpress.ru/order_detail.htm?orderId=5017385647722510&orderSource=GlobalTrade) | 355.04 | 99.52 | 454.56 | 22.728
ATxmega32a4 | 10 | aliexpress.com | 2022-03-10 |  | #5017422385892510 (https://trade.aliexpress.ru/order_detail.htm?orderId=5017422385892510&orderSource=GlobalTrade) | 4919.67 |  | 4919.67 | 491.967
~~ATxmega128a1u~~ | ~~10~~ | ~~aliexpress.com~~ | ~~2022-03-10~~ |  | ~~#5017405636652510~~ (https://trade.aliexpress.ru/order_detail.htm?orderId=5017405636652510&orderSource=GlobalTrade) | ~~13640.01~~ | ~~2122.15~~ | ~~15762.16~~ | ~~1576.216~~ | -15762.16 | cancelled
DS-5-01 | 300 | aliexpress.com | 2022-03-14 |  | #5017461801272510 (https://trade.aliexpress.ru/order_detail.htm?orderId=5017461801272510&orderSource=GlobalTrade) | 6604.81 | 1711.62 | 8316.43 | 27.72143333
HCPL-2631 | 100 | aliexpress.com | 2022-03-14 |  | #5017392970742510 (https://trade.aliexpress.ru/order_detail.htm?orderId=5017392970742510&orderSource=GlobalTrade) | 3956.26 | 549.57 | 4505.83 | 45.0583
 |  | chipdip.ru | 2022-03-21 |  | #8338098 (https://www.chipdip.ru/order/detail/8338098) | 651 |  | 651
PCB splitter x6-2 | 20 | rezonit.ru | 2022-03-22 |  | #1517354 (https://service.rezonit.ru/orders/1168288) |  |  | 7624.08 | 381.204
 |  | chipdip.ru | 2022-03-22 |  | #8341083 (https://www.chipdip.ru/order/detail/8341083) | 4430 |  | 4430
 |  | terraelectronica.ru | 2022-03-22 |  | #07863451 (https://www.terraelectronica.ru/order/07863451) | 10778.4 | 236 | 11014.4
L-13GD | 70 | chipdip.ru | 2022-03-22 |  | #8341104 (https://www.chipdip.ru/order/detail/8341104) | 2030 |  | 2030 | 29
MF-MSMF050-2 | 60 | aliexpress.com | 2022-03-22 |  | #4000903717748 (https://www.aliexpress.ru/item/4000903717748.html) | 582.63 | 245.58 | 828.21 | 13.8035
USBLC6-2SC6 | 100 | aliexpress.com | 2022-03-22 |  | #5018927329292510 (https://trade.aliexpress.ru/order_detail.htm?orderId=5018927329292510&orderSource=GlobalTrade) | 519.98 | 92.72 | 612.7 | 6.127
LD1117S33 | 30 | aliexpress.com | 2022-03-22 |  | #5018927329312510 (https://trade.aliexpress.ru/order_detail.htm?orderId=5018927329312510&orderSource=GlobalTrade) | 417.24 | 127.8 | 545.04 | 18.168
2x10 SMD socket | 10 | aliexpress.com | 2022-03-22 |  | #5018927329252510 (https://trade.aliexpress.ru/order_detail.htm?orderId=5018927329252510&orderSource=GlobalTrade) | 328.28 | 527.5 | 855.78 | 85.578
cтойка латунная PCHSS-18 | 20 | aliexpress.com | 2022-03-23 |  | #5018771842962510 (https://trade.aliexpress.ru/order_detail.htm?orderId=5018771842962510&orderSource=GlobalTrade) | 620 |  | 620 | 31
винт М3x6 | 50 | aliexpress.com | 2022-03-23 |  | #5018770085192510 (https://trade.aliexpress.ru/order_detail.htm?orderId=5018770085192510&orderSource=GlobalTrade) | 257.1 |  | 257.1 | 5.142
~~ATxmega128a1u~~ | ~~10~~ | ~~aliexpress.com~~ | ~~2022-03-24~~ |  | ~~#5018884017692510~~ (https://www.aliexpress.com/p/order/detail.html?orderId=5018884017692510) | ~~13213.8~~ |  | ~~13213.8~~ | ~~1321.38~~ | -12443.8 | refund
~~ATxmega32a4u~~ | ~~10~~ | ~~aliexpress.com~~ | ~~2022-04-11~~ |  | #5019149229082510 (https://www.aliexpress.com/p/order/detail.html?orderId=5019149229082510) | ~~4661.75~~ | ~~272.58~~ | ~~4934.33~~ | ~~493.433~~ | -4164.33 | refund
~~ATxmega128a1u~~ | ~~10~~ | ~~aliexpress.com~~ | ~~2022-04-12~~ |  | #5019091516212510 (https://www.aliexpress.com/p/order/detail.html?orderId=5019091516212510) | ~~13767.37~~ | ~~550.93~~ | ~~14318.3~~ | ~~1431.83~~ | -13548.3 | refund
ATxmega128a1u | 1 | aliexpress.com | 2022-04-20 |  | #5022549706122510 (https://www.aliexpress.com/p/order/detail.html?orderId=5022549706122510) | 1650 | 182.11 | 1832.11 | 1832.11
~~ATxmega128a1u~~ | ~~10~~ | ~~aliexpress.com~~ | 2022-04-20 |  | #5022598776312510 (https://www.aliexpress.com/p/order/detail.html?orderId=5022598776312510) | ~~18366.19~~ | ~~294.78~~ | ~~18660.97~~ | ~~1866.097~~ | -17890.97 | refund
~~ATxmega32a4u~~ | ~~10~~ | ~~aliexpress.com~~ | 2022-04-23 |  | #5023777132102510 (https://www.aliexpress.com/p/order/detail.html?orderId=5023777132102510) | ~~4030.66~~ |  | ~~4030.66~~ | ~~403.066~~ | -4800.66 | refund
~~ATxmega32a4u~~ | ~~10~~ | ~~aliexpress.com~~ | 2022-04-23 |  | #5023777132082510 (https://www.aliexpress.com/p/order/detail.html?orderId=5023777132082510) | ~~4335.96~~ |  | ~~4335.96~~ | ~~433.596~~ | -3565.96 | refund
ATxmega128a1u | 10 | aliexpress.com | 2022-04-29 |  | #5026729678802510 (https://www.aliexpress.com/p/order/detail.html?orderId=5026729678802510) | 22401.48 |  | 22401.48 | 2240.148
~~ATxmega32a4u~~ | ~~10~~ | ~~aliexpress.com~~ | ~~2022-05-11~~ |  | ~~#5029011525452510~~ (https://www.aliexpress.com/p/order/detail.html?orderId=5029011525452510) | ~~9818.06~~ | ~~256.16~~ | ~~10074.22~~ | ~~1007.422~~ | -9304.22 | refund
ATxmega32a4u | 10 | aliexpress.com | 2022-05-23 |  | #5029396850582510 (https://www.aliexpress.com/p/order/detail.html?orderId=5029396850582510) | 8969.3 |  | 8969.3 | 896.93
~~ATxmega32a4u~~ | ~~10~~ | ~~aliexpress.com~~ | ~~2022-05-30~~ |  | ~~#5029521301972510~~ (https://www.aliexpress.com/p/order/detail.html?orderId=5029521301972510) | ~~24409.15~~ |  | ~~24409.15~~ | ~~2440.915~~ | -24409.15 | refund
BAS316,115 | 200 | chipdip.ru | 2022-07-06 |  | #5180376 (https://www.chipdip.ru/order/item/5180376) | 2760 |  | 2760 | 13.8
ATxmega32a4u | 10 | aliexpress.com | 2022-07-09 |  | #5030 3427 7283 2510 (https://trade.aliexpress.ru/order_detail.htm?orderId=5030342772832510&orderSource=GlobalTrade) | 9280.43 |  | 9280.43 | 928.043
PCB router x7 | 10 | jlcpcb.com | 2022-07-29 |  | #Y35-2346369A (https://jlcpcb.com/orderDetails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) | 894.11 | 564.54 | 1458.65 | 145.865
DS-5-01 MIDI | 100 | aliexpress.com | 2022-08-23 |  | #5053 4518 2160 2510 (https://trade.aliexpress.ru/order_detail.htm?orderId=5053451821602510&orderSource=GlobalTrade) | 632.07 | 566.92 | 1198.99 | 11.9899
кнопка Mode | 6 | aliexpress.com | 2022-08-23 |  | #5053 4517 4234 2510 (https://aliexpress.ru/order-list/5053451742342510) | 643.56 | 208.77 | 852.33 | 142.055
кнопка включения | 5 | aliexpress.com | 2022-08-23 |  | #5053 4517 4236 2510 (https://aliexpress.ru/order-list/5053451742362510) | 861.91 | 171.11 | 1033.02 | 206.604
PCB router x4 flat | 10 | jlcpcb.com | 2022-08-29 |  | #Y40-2346369A (https://jlcpcb.com/orderDetails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) | 313.3 | 452.48 | 765.78 | 76.578
ATxmega128a1u | 10 | aliexpress.com | 2022-08-30 |  | #5057 2260 7283 2510 (https://trade.aliexpress.ru/order_detail.htm?orderId=5057226072832510&orderSource=GlobalTrade) | 35737.5 |  | 35737.5 | 3573.75
FormaX | 750 | ozon.ru | 2022-08-31 |  | #02701602-0049 (https://www.ozon.ru/my/orderdetails/?order=02701602-0049) | 5292 |  | 5292 | 7.056
HCPL-2631 | 100 | aliexpress.com | 2022-09-04 |  | #5060 6502 6098 2510 (https://trade.aliexpress.ru/order_detail.htm?orderId=5060650260982510&orderSource=GlobalTrade) | 1607.3 | 291.37 | 1898.67 | 18.9867
саморезы М2x12, pan head | 100 | aliexpress.com | 2022-10-12 | 2022-11-05 | #5087 5392 0224 2510 (https://aliexpress.ru/order-list/5087539202242510) | 141.93 |  | 141.93 | 1.4193
74HC541W TSSOP-20 | 50 | aliexpress.com | 2022-10-12 | 2022-11-05 | #5087 4386 0087 2510 (https://aliexpress.ru/order-list/5087438600872510) | 966.09 | 272.61 | 1238.7 | 24.774
саморезы М2x12, pan head | 100 | aliexpress.com | 2022-10-13 | 2022-10-25 | #5087 0620 7231 2510 (https://aliexpress.ru/order-list/5087062072312510) | 121.55 |  | 121.55 | 1.2155
DS-5-01 MIDI | 200 | aliexpress.com | 2022-10-23 | 2022-11-07 | #5089 6559 2508 2510 (https://aliexpress.ru/order-list/5089655925082510) | 1369.16 | 1273.04 | 2642.2 | 13.211
ATxmega32a4u | 10 | aliexpress.com | 2022-10-23 | 2022-11-26 | #5089 4462 9516 2510 (https://aliexpress.ru/order-list/5089446295162510) | 8147.86 |  | 8147.86 | 814.786
 |  | electronshik.ru | 2022-10-23 | 2022-10-28 | #1433936 (https://www.electronshik.ru/profile/order/1433936) | 3534.6 | 236 | 3770.6
 |  | chipdip.ru | 2022-11-03 |  | #9311171 (https://www.chipdip.ru/order/detail/9311171) | 2450 | 99 | 2549
FormaX | 1500 | lider-3d.ru | 2022-11-05 | 2022-11-05 | #4991 (https://lider-3d.ru/personal/orders/4991/) | 10880 |  | 10880 | 7.253333333
ATxmega128a4u | 2 | aliexpress.com | 2022-11-07 | 2022-12-03 | #5090 6499 6454 2510 (https://aliexpress.ru/order-list/5090649964542510) | 3994.82 | 201.07 | 4195.89 | 2097.945
ATxmega128a4u | 2 | aliexpress.com | 2022-11-07 | 2022-11-26 | #5090 6499 6458 2510 (https://aliexpress.ru/order-list/5090649964582510) | 4594.04 | 189.09 | 4783.13 | 2391.565
PCB router x7 Rack | 5 | jlcpcb.com | 2022-11-09 | 2022-12-18 | #W202211090524366 (https://jlcpcb.com/orderDetails?batchNum=W202211090524366) | 1727.71 | 842.69 | 2570.4 | 514.08
ATxmega128a1u | 10 | aliexpress.com | 2022-11-21 | 2022-12-18 | #5091 7381 4641 2510 (https://aliexpress.ru/order-list/5091738146412510) | 34325.76 |  | 34325.76 | 3432.576
ATxmega128a1u | 10 | aliexpress.com | 2022-11-22 | 2022-12-17 | #5091 8810 0008 2510 (https://aliexpress.ru/order-list/5091881000082510) | 34622.51 |  | 34622.51 | 3462.251
 |  | chipdip.ru | 2023-01-04 |  | #9592382 (https://www.chipdip.ru/order/detail/9592382) | 1410 |  | 1410
 |  | chipdip.ru | 2023-01-04 |  | #9593959 (https://www.chipdip.ru/order/detail/9593959) | 410 |  | 410
PCB router x7 | 10 | jlcpcb.com | 2023-01-16 | 2023-02-24 | #W2023011620161011 (https://jlcpcb.com/orderDetails?batchNum=W2023011620161011) | 1085.11 | 608.74 | 1693.85 | 169.385
PCB router x4 flat | 10 | jlcpcb.com | 2023-01-16 | 2023-02-24 | #W2023011620161011 (https://jlcpcb.com/orderDetails?batchNum=W2023011620161011) | 384.79 | 608.74 | 993.53 | 99.353
 |  | chipdip.ru | 2023-01-31 |  | #9723129 (https://www.chipdip.ru/order/detail/9723129) | 2030 |  | 2030
 |  | electronshik.ru | 2023-02-04 | 2023-02-06 | #1453612 (https://www.electronshik.ru/profile/order/1453612) | 3954.72 | 236 | 4190.72
74HC541W TSSOP-20 | 100 | aliexpress.com | 2023-02-21 | 2023-03-15 | #5116 1289 4352 2510 (https://aliexpress.ru/order-list/5116128943522510) | 2040.1 | 394.42 | 2434.52 | 24.3452
LD1117S33 SOT-223 | 100 | aliexpress.com | 2023-02-21 | 2023-03-15 | #5116 1287 0688 2510 (https://aliexpress.ru/order-list/5116128706882510) | 916.2 | 272.52 | 1188.72 | 11.8872
MF-MSMF050-2 | 100 | aliexpress.com | 2023-02-21 | 2023-03-15 | #5116 1287 0686 2510 (https://aliexpress.ru/order-list/5116128706862510) | 179.36 | 81.52 | 260.88 | 2.6088
SCS-8 (DS1009-8AN), DIP-8 панель | 100 | chipdip.ru | 2023-02-24 |  | #9856173 (https://www.chipdip.ru/order/detail/9856173) | 800 |  | 800 | 8
кнопка включения | 5 | aliexpress.com | 2023-03-07 | 2023-03-22 | #5123 1758 5036 2510 (https://aliexpress.ru/order-list/5123175850362510) | 1083.7 | 214.35 | 1298.05 | 259.61
кнопка Mode | 6 | aliexpress.com | 2023-03-07 | 2023-03-19 | #5123 1758 5034 2510 (https://aliexpress.ru/order-list/5123175850342510) | 808.62 | 275.13 | 1083.75 | 180.625
~~ATxmega128a1u~~ | ~~10~~ | ~~aliexpress.com~~ | ~~2023-03-07~~ | ~~2023-03-22~~ | #5122 9440 6926 2510 (https://aliexpress.ru/order-list/5122944069262510) | ~~27225.3~~ | ~~628.65~~ | ~~27853.95~~ | ~~2785.395~~ | -27083.95 | refund
DS-5-01 MIDI | 200 | aliexpress.com | 2023-03-07 |  | #5123 3198 4185 2510 (https://aliexpress.ru/order-list/5123319841852510) | 1218.1 | 1522.82 | 2740.92 | 13.7046
HC49 SMD 16MHz | 50 | aliexpress.com | 2023-03-11 | 2023-03-19 | #2303 1147 8042 1099 (https://aliexpress.ru/order-list/2303114780421099) | 450 | 199 | 649 | 12.98
 |  | electronshik.ru | 2023-03-11 |  | #1460615 (https://www.electronshik.ru/profile/order/1460615) | 845.76 |  | 845.76
ATxmega128a1u | 10 | aliexpress.com | 2023-03-22 |  | #5129 0277 2691 2510 (https://aliexpress.ru/order-list/5129027726912510) | 37772.27 | 462.46 | 38234.73 | 3823.473
total |  |  |  |  |  | 448198.97 | 25024.59 | 480847.64 |  | -132973.5
 |  |  |  |  |  |  |  | 347874.14

Sheet: Sheet1
0.01 uF
0.1 uF
10 uF
15 pF
BAS316.115
MF-MSMF050-2
0 Ohm
100 Ohm
220 Ohm
470 Ohm
1 KOhm
10 KOhm
100 KOhm
74AHC1G125
74HCT541
LD1117S33TR
USBLC6-2SC6
