mar0x/midi_router/box/MIDI-Lab-1-Extrude.step

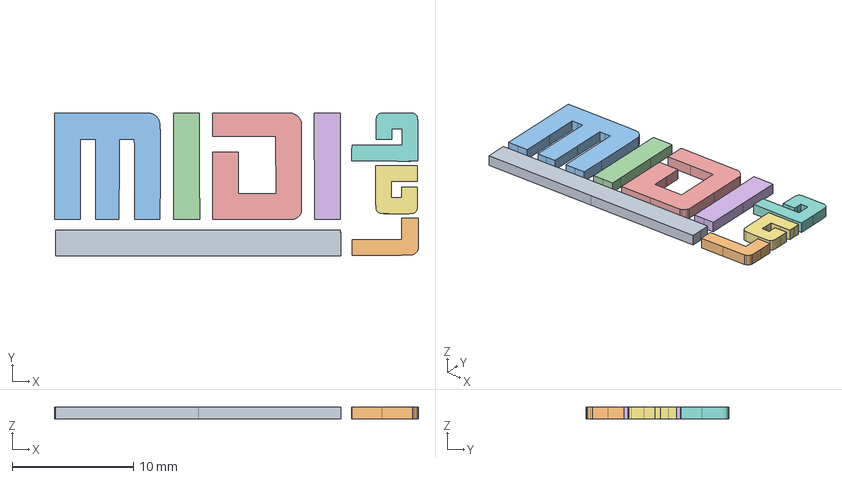
[picture p2: CAD file, 2021-07-27]
box/MIDI-Lab-1-Extrude.step
30.0 x 11.8 x 1.00 mm
