mar0x/midi_router/doc/midi_routing.pdf

# "Basic" USB Routing 4x4 USB MIDI Out 1 USB MIDI Out 2

# "Classic Splitter" 1x4 USB MIDI Out 1 USB MIDI Out 2

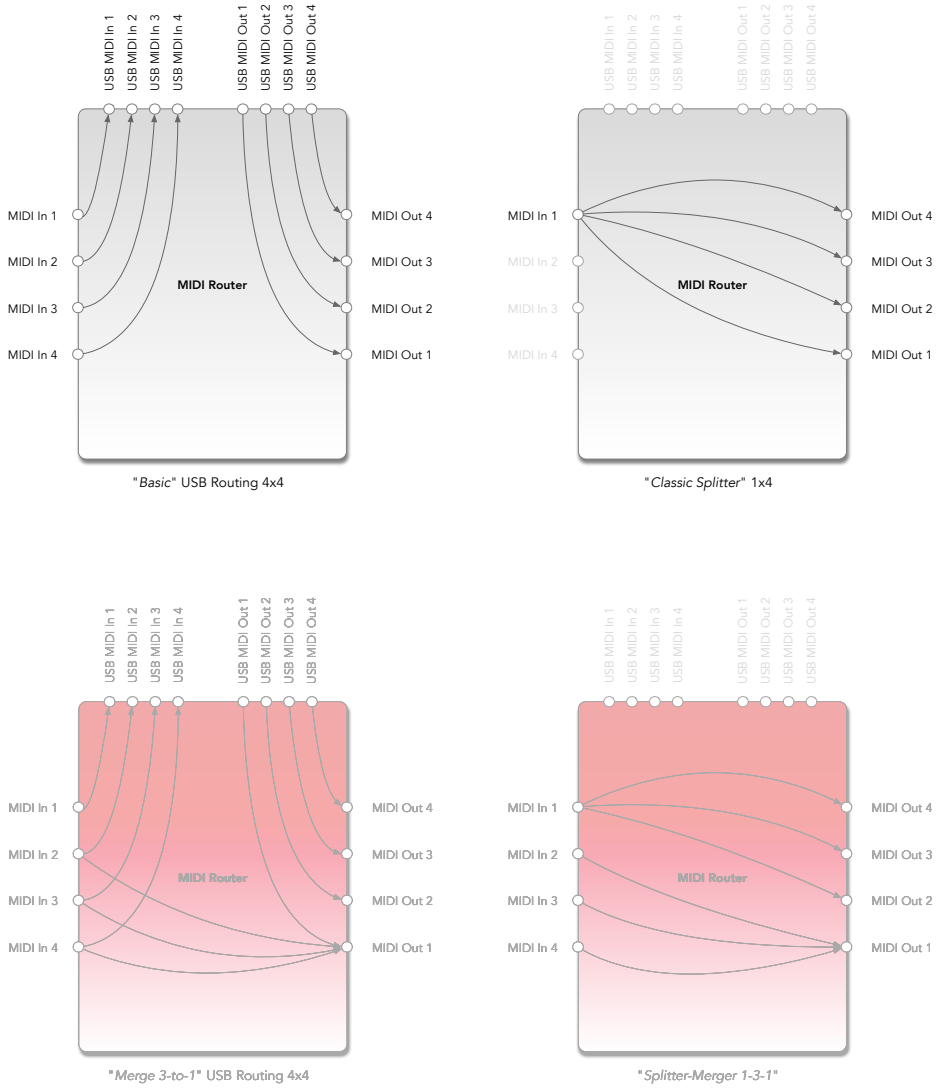
[picture p3: page 1]
MIDI Router; MIDI In 2; MIDI In 3; MIDI In 4; MIDI Out 2; MIDI Out 3; MIDI Out 4; MIDI In 1; MIDI Out 1

USB MIDI Out 3

USB MIDI Out 4

USB MIDI In 1

USB MIDI In 2

USB MIDI In 3

USB MIDI In 4

MIDI In 1
"Merge 3-to-1" USB Routing 4x4 USB MIDI Out 1 USB MIDI Out 2 USB MIDI Out 3 USB MIDI Out 4

MIDI Out 1
"Splitter-Merger 1-3-1" USB MIDI Out 1 USB MIDI Out 2
