mar0x/midi_router/kicad/x4-top/usb_midi_x4_top.kicad_pcb

## KiCad design kicad/x4-top/usb_midi_x4_top.kicad_pcb (2024-06-15)

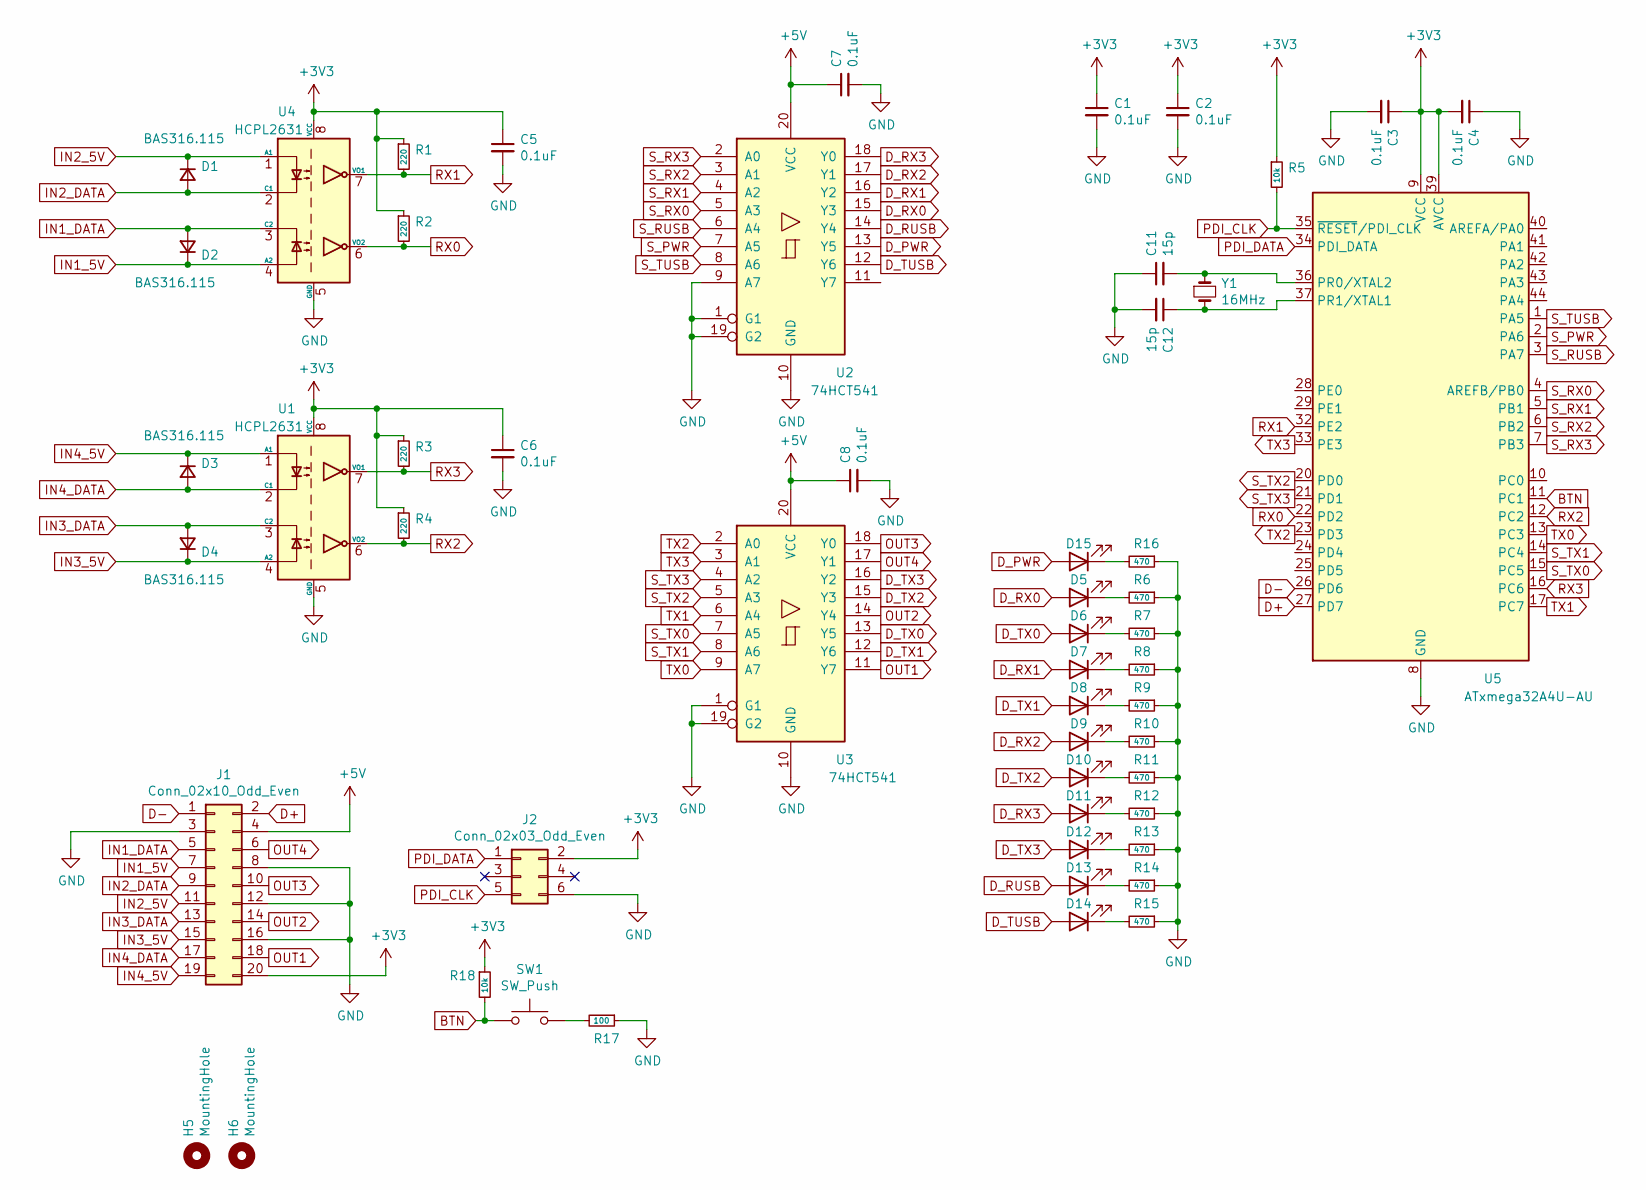
[picture p4: schematic usb_midi_x4_top.kicad_sch]

Parts:
C1, C2, C3, C4, C5, C6, C7, C8: 0.1uF; C_0805_2012Metric
C11, C12: 15p; C_0805_2012Metric
D1, D2, D3, D4: BAS316.115; D_SOD-323_HandSoldering
D5, D6, D7, D8, D9, D10, D11, D12, D13, D14, D15: LED; LED_D2.0mm_W4.8mm_Horizontal_O1.27mm_Z2.0mm
H5, H6: MountingHole; MountingHole_3.2mm_M3_Pad
J1: Conn_02x10_Odd_Even; PinSocket_2x10_P2.54mm_Vertical_SMD
J2: Conn_02x03_Odd_Even; IDC-Header_2x03_P2.54mm_Vertical
R1, R2, R3, R4: 220; R_0805_2012Metric
R5, R18: 10k; R_0805_2012Metric
R6, R7, R8, R9, R10, R11, R12, R13, R14, R15, R16: 470; R_0805_2012Metric
R17: 100; R_0805_2012Metric
SW1: SW_Push; SW_Tactile_SPST_Angled_PTS645Vx58-2LFS
U1, U4: HCPL2631; DIP-8_W7.62mm
U2, U3: 74HCT541; TSSOP-20_4.4x6.5mm_P0.65mm
U5: ATxmega32A4U-AU; TQFP-44_10x10mm_P0.8mm
Y1: 16MHz; Crystal_SMD_HC49-SD

Connections:
+3V3: C1.1, C2.1, C3.1, C4.2, C5.1, C6.1, J1.20, J2.2, R1.1, R2.1, R3.1, R4.1, R5.1, R18.1, U1.8 (VCC), U4.8 (VCC), U5.9 (VCC), U5.19 (VCC), U5.31 (VCC), U5.39 (AVCC)
+5V: C7.1, C8.1, J1.4, U2.20 (VCC), U3.20 (VCC)
BTN: R18.2, SW1.1, U5.11 (PC1)
D+: J1.2, U5.27 (PD7)
D-: J1.1, U5.26 (PD6)
D_PWR: D15.2 (A), U2.13 (Y5)
D_RUSB: D13.2 (A), U2.14 (Y4)
D_RX0: D5.2 (A), U2.15 (Y3)
D_RX1: D7.2 (A), U2.16 (Y2)
D_RX2: D9.2 (A), U2.17 (Y1)
D_RX3: D11.2 (A), U2.18 (Y0)
D_TUSB: D14.2 (A), U2.12 (Y6)
D_TX0: D6.2 (A), U3.13 (Y5)
D_TX1: D8.2 (A), U3.12 (Y6)
D_TX2: D10.2 (A), U3.15 (Y3)
D_TX3: D12.2 (A), U3.16 (Y2)
GND: C1.2, C2.2, C3.2, C4.1, C5.2, C6.2, C7.2, C8.2, C11.1, C12.2, J1.3, J1.8, J1.12, J1.16, J2.6, R6.1, R7.1, R8.1, R9.1, R10.1, R11.1, R12.1, R13.1, R14.1, R15.1, R16.1, R17.1, U1.5 (GND), U2.1 (G1), U2.9 (A7), U2.10 (GND), U2.19 (G2), U3.1 (G1), U3.10 (GND), U3.19 (G2), U4.5 (GND), U5.8 (GND), U5.18 (GND), U5.30 (GND), U5.38 (GND)
IN1_5V: D2.1 (K), J1.7, U4.4 (A2)
IN1_DATA: D2.2 (A), J1.5, U4.3 (C2)
IN2_5V: D1.1 (K), J1.11, U4.1 (A1)
IN2_DATA: D1.2 (A), J1.9, U4.2 (C1)
IN3_5V: D4.1 (K), J1.15, U1.4 (A2)
IN3_DATA: D4.2 (A), J1.13, U1.3 (C2)
IN4_5V: D3.1 (K), J1.19, U1.1 (A1)
IN4_DATA: D3.2 (A), J1.17, U1.2 (C1)
unnamed: C11.2, U5.36 (PR0/XTAL2), Y1.1
unnamed: C12.1, U5.37 (PR1/XTAL1), Y1.2
unnamed: D5.1 (K), R6.2
unnamed: D6.1 (K), R7.2
unnamed: D7.1 (K), R8.2
unnamed: D8.1 (K), R9.2
unnamed: D9.1 (K), R10.2
unnamed: D10.1 (K), R11.2
unnamed: D11.1 (K), R12.2
unnamed: D12.1 (K), R13.2
unnamed: D13.1 (K), R14.2
unnamed: D14.1 (K), R15.2
unnamed: D15.1 (K), R16.2
unnamed: R17.2, SW1.2
OUT1: J1.18, U3.11 (Y7)
OUT2: J1.14, U3.14 (Y4)
OUT3: J1.10, U3.18 (Y0)
OUT4: J1.6, U3.17 (Y1)
PDI_CLK: J2.5, R5.2, U5.35 (~RESET/PDI_CLK)
PDI_DATA: J2.1, U5.34 (PDI_DATA)
RX0: R2.2, U4.6 (VO2), U5.22 (PD2)
RX1: R1.2, U4.7 (VO1), U5.32 (PE2)
RX2: R4.2, U1.6 (VO2), U5.12 (PC2)
RX3: R3.2, U1.7 (VO1), U5.16 (PC6)
S_PWR: U2.7 (A5), U5.2 (PA6)
S_RUSB: U2.6 (A4), U5.3 (PA7)
S_RX0: U2.5 (A3), U5.4 (AREFB/PB0)
S_RX1: U2.4 (A2), U5.5 (PB1)
S_RX2: U2.3 (A1), U5.6 (PB2)
S_RX3: U2.2 (A0), U5.7 (PB3)
S_TUSB: U2.8 (A6), U5.1 (PA5)
S_TX0: U3.7 (A5), U5.15 (PC5)
S_TX1: U3.8 (A6), U5.14 (PC4)
S_TX2: U3.5 (A3), U5.20 (PD0)
S_TX3: U3.4 (A2), U5.21 (PD1)
TX0: U3.9 (A7), U5.13 (PC3)
TX1: U3.6 (A4), U5.17 (PC7)
TX2: U3.2 (A0), U5.23 (PD3)
TX3: U3.3 (A1), U5.33 (PE3)

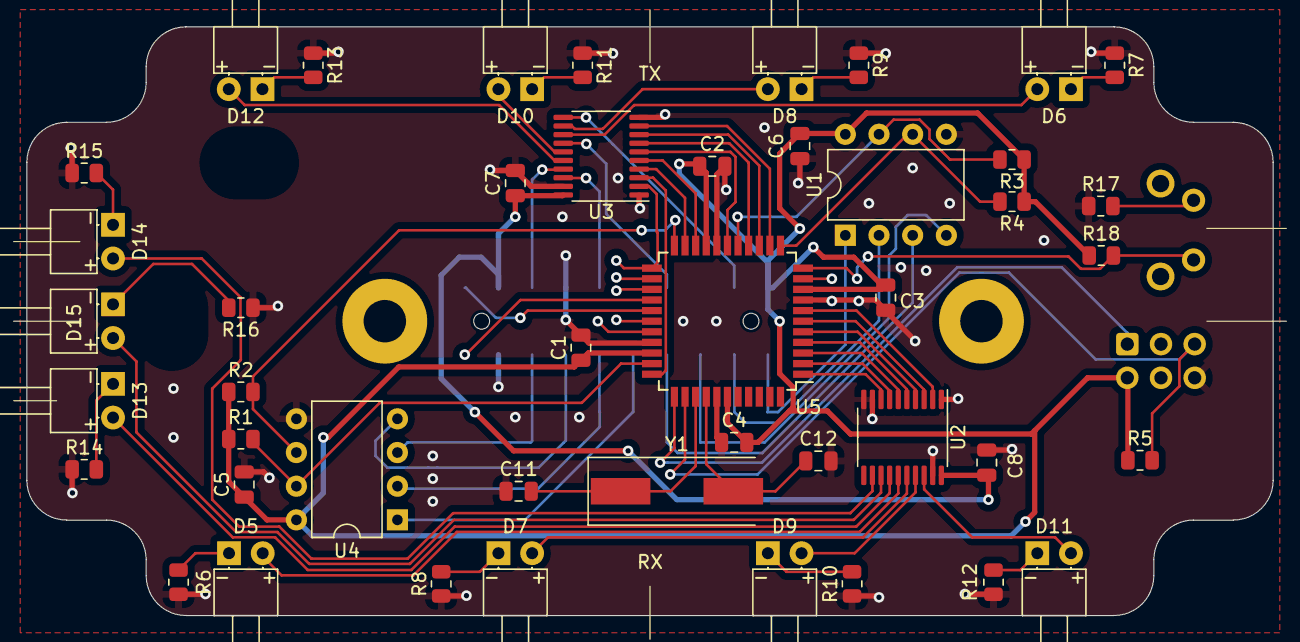
[picture p5: board usb_midi_x4_top.kicad_pcb from above]

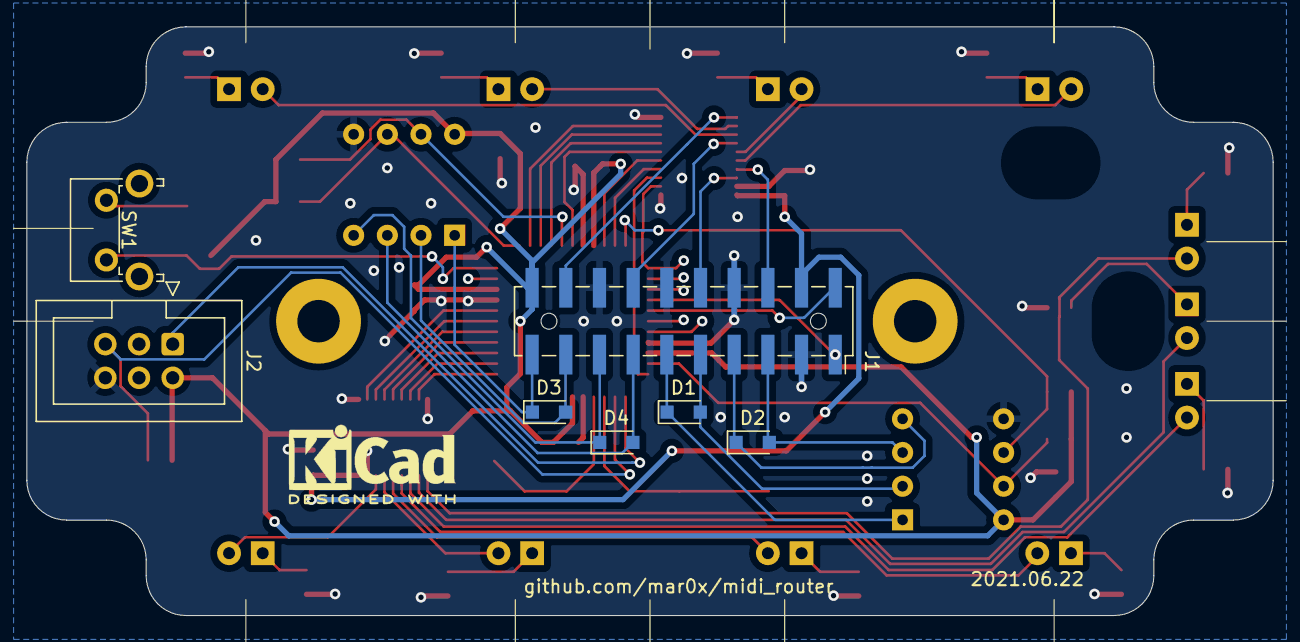
[picture p6: board usb_midi_x4_top.kicad_pcb from below]

Board: 2 copper layers, 94.0 x 44.4 mm, 54 parts (7 on the bottom side), 64 nets.
