mar0x/midi_router/kicad/x7/midi_router_x7.kicad_pcb

## KiCad design kicad/x7/midi_router_x7.kicad_pcb (2024-06-15)

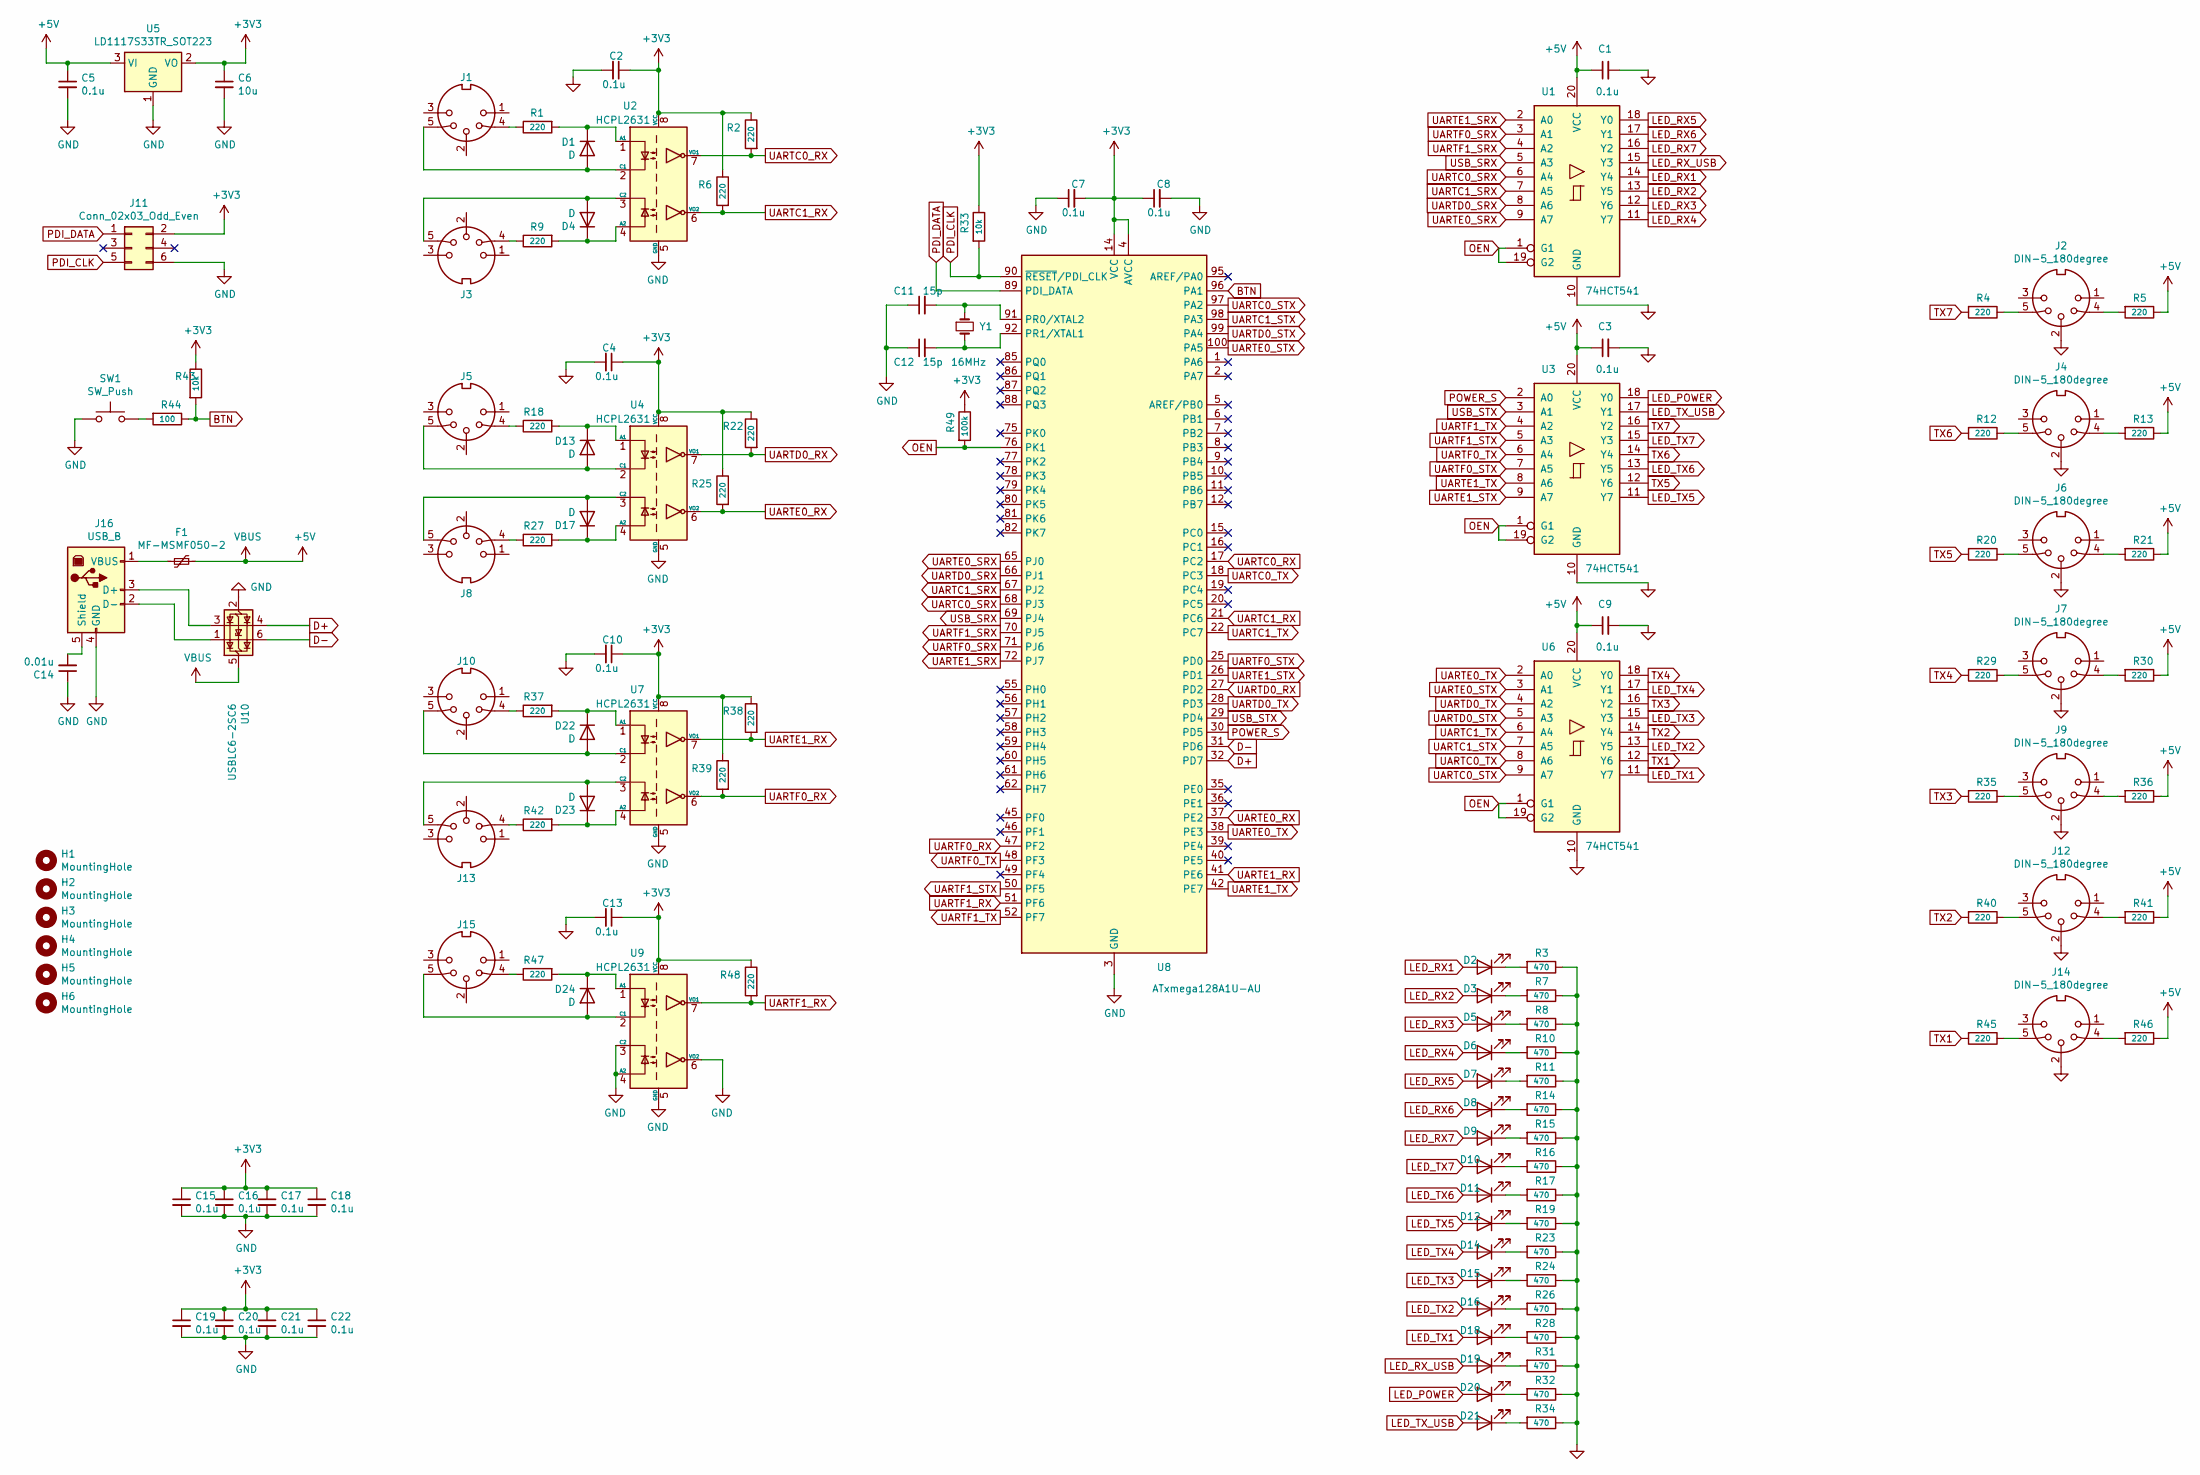
[picture p7: schematic midi_router_x7.kicad_sch]

Parts:
C1, C2, C3, C4, C5, C7, C8, C9, C10, C13, C15, C16, C17, C18, C19, C20, C21, C22: 0.1u; C_0805_2012Metric
C6: 10u; C_0805_2012Metric
C11, C12: 15p; C_0805_2012Metric
C14: 0.01u; C_0805_2012Metric
D1, D4, D13, D17, D22, D23, D24: D; D_SOD-323_HandSoldering
D2, D3, D5, D6, D7, D8, D9, D19: L-383YDT; PinSocket_1x02_P2.54mm_Vertical
D10, D11, D12, D14, D15, D16, D18, D21: L-383GDT; PinSocket_1x02_P2.54mm_Vertical
D20: L-383ID; PinSocket_1x02_P2.54mm_Vertical
F1: MF-MSMF050-2; Fuse_1812_4532Metric_Castellated
H1, H2, H3, H4, H5, H6: MountingHole; MountingHole_3.2mm_M3
J1, J2, J3, J4, J5, J6, J7, J8, J9, J10, J12, J13, J14, J15: DIN-5_180degree; DIN5MIDI-OOTDTY
J11: Conn_02x03_Odd_Even; IDC-Header_2x03_P2.54mm_Vertical
J16: USB_B; USB_B_OST_USB-B1HSxx_Horizontal
R1, R2, R4, R5, R6, R9, R12, R13, R18, R20, R21, R22, R25, R27, R29, R30, R35, R36, R37, R38, R39, R40, R41, R42, R45, R46, R47, R48: 220; R_0805_2012Metric
R3, R7, R8, R10, R11, R14, R15, R16, R17, R19, R23, R24, R26, R28, R31, R32, R34: 470; R_0805_2012Metric
R33, R43: 10k; R_0805_2012Metric
R44: 100; R_0805_2012Metric
R49: 100k; R_0805_2012Metric
SW1: SW_Push; SW_Tactile_SPST_Angled_PTS645Vx58-2LFS
U1, U3, U6: 74HCT541; TSSOP-20_4.4x6.5mm_P0.65mm
U2, U4, U7, U9: HCPL2631; DIP-8_W7.62mm
U5: LD1117S33TR_SOT223; SOT-223-3_TabPin2
U8: ATxmega128A1U-AU; TQFP-100_14x14mm_P0.5mm
U10: USBLC6-2SC6; SOT-23-6
Y1: 16MHz; Crystal_SMD_HC49-SD

Connections:
+3V3: C2.1, C4.1, C6.1, C7.2, C8.1, C10.1, C13.1, C15.1, C16.1, C17.1, C18.1, C19.1, C20.1, C21.1, C22.1, J11.2, R2.1, R6.1, R22.1, R25.1, R33.1, R38.1, R39.1, R43.1, R48.1, R49.1, U2.8 (VCC), U4.8 (VCC), U5.2 (VO), U7.8 (VCC), U8.4 (AVCC), U8.14 (VCC), U8.24 (VCC), U8.34 (VCC), U8.44 (VCC), U8.54 (VCC), U8.64 (VCC), U8.74 (VCC), U8.83 (VCC), U8.94 (AVCC), U9.8 (VCC)
+5V: C1.1, C3.1, C5.1, C9.1, F1.1, R5.1, R13.1, R21.1, R30.1, R36.1, R41.1, R46.1, U1.20 (VCC), U3.20 (VCC), U5.3 (VI), U6.20 (VCC), U10.5 (VBUS)
BTN: R43.2, R44.1, U8.96 (PA1)
D+: U8.32 (PD7), U10.4 (I/O2)
D-: U8.31 (PD6), U10.6 (I/O1)
GND: C1.2, C2.2, C3.2, C4.2, C5.2, C6.2, C7.1, C8.2, C9.2, C10.2, C11.1, C12.1, C13.2, C14.1, C15.2, C16.2, C17.2, C18.2, C19.2, C20.2, C21.2, C22.2, J2.2, J4.2, J6.2, J7.2, J9.2, J11.6, J12.2, J14.2, J16.4 (GND), R3.1, R7.1, R8.1, R10.1, R11.1, R14.1, R15.1, R16.1, R17.1, R19.1, R23.1, R24.1, R26.1, R28.1, R31.1, R32.1, R34.1, SW1.1, U1.10 (GND), U2.5 (GND), U3.10 (GND), U4.5 (GND), U5.1 (GND), U6.10 (GND), U7.5 (GND), U8.3 (GND), U8.13 (GND), U8.23 (GND), U8.33 (GND), U8.43 (GND), U8.53 (GND), U8.63 (GND), U8.73 (GND), U8.84 (GND), U8.93 (GND), U9.3 (C2), U9.4 (A2), U9.5 (GND), U9.6 (VO2), U10.2 (GND)
LED_POWER: D20.2 (A), U3.18 (Y0)
LED_RX1: D2.2 (A), U1.14 (Y4)
LED_RX2: D3.2 (A), U1.13 (Y5)
LED_RX3: D5.2 (A), U1.12 (Y6)
LED_RX4: D6.2 (A), U1.11 (Y7)
LED_RX5: D7.2 (A), U1.18 (Y0)
LED_RX6: D8.2 (A), U1.17 (Y1)
LED_RX7: D9.2 (A), U1.16 (Y2)
LED_RX_USB: D19.2 (A), U1.15 (Y3)
LED_TX1: D18.2 (A), U6.11 (Y7)
LED_TX2: D16.2 (A), U6.13 (Y5)
LED_TX3: D15.2 (A), U6.15 (Y3)
LED_TX4: D14.2 (A), U6.17 (Y1)
LED_TX5: D12.2 (A), U3.11 (Y7)
LED_TX6: D11.2 (A), U3.13 (Y5)
LED_TX7: D10.2 (A), U3.15 (Y3)
LED_TX_USB: D21.2 (A), U3.17 (Y1)
unnamed: C11.2, U8.91 (PR0/XTAL2), Y1.1
unnamed: C12.2, U8.92 (PR1/XTAL1), Y1.2
unnamed: C14.2, J16.5 (Shield)
unnamed: D1.1 (K), R1.2, U2.1 (A1)
unnamed: D1.2 (A), J1.5, U2.2 (C1)
unnamed: D2.1 (K), R3.2
unnamed: D3.1 (K), R7.2
unnamed: D4.1 (K), R9.2, U2.4 (A2)
unnamed: D4.2 (A), J3.5, U2.3 (C2)
unnamed: D5.1 (K), R8.2
unnamed: D6.1 (K), R10.2
unnamed: D7.1 (K), R11.2
unnamed: D8.1 (K), R14.2
unnamed: D9.1 (K), R15.2
unnamed: D10.1 (K), R16.2
unnamed: D11.1 (K), R17.2
unnamed: D12.1 (K), R19.2
unnamed: D13.1 (K), R18.2, U4.1 (A1)
unnamed: D13.2 (A), J5.5, U4.2 (C1)
unnamed: D14.1 (K), R23.2
unnamed: D15.1 (K), R24.2
unnamed: D16.1 (K), R26.2
unnamed: D17.1 (K), R27.2, U4.4 (A2)
unnamed: D17.2 (A), J8.5, U4.3 (C2)
unnamed: D18.1 (K), R28.2
unnamed: D19.1 (K), R31.2
unnamed: D20.1 (K), R32.2
unnamed: D21.1 (K), R34.2
unnamed: D22.1 (K), R37.2, U7.1 (A1)
unnamed: D22.2 (A), J10.5, U7.2 (C1)
unnamed: D23.1 (K), R42.2, U7.4 (A2)
unnamed: D23.2 (A), J13.5, U7.3 (C2)
unnamed: D24.1 (K), R47.2, U9.1 (A1)
unnamed: D24.2 (A), J15.5, U9.2 (C1)
unnamed: F1.2, J16.1 (VBUS)
unnamed: J1.4, R1.1
unnamed: J2.4, R5.2
unnamed: J2.5, R4.1
unnamed: J3.4, R9.1
unnamed: J4.4, R13.2
unnamed: J4.5, R12.1
unnamed: J5.4, R18.1
unnamed: J6.4, R21.2
unnamed: J6.5, R20.1
unnamed: J7.4, R30.2
unnamed: J7.5, R29.1
unnamed: J8.4, R27.1
unnamed: J9.4, R36.2
unnamed: J9.5, R35.1
unnamed: J10.4, R37.1
unnamed: J12.4, R41.2
unnamed: J12.5, R40.1
unnamed: J13.4, R42.1
unnamed: J14.4, R46.2
unnamed: J14.5, R45.1
unnamed: J15.4, R47.1
unnamed: J16.2 (D-), U10.1 (I/O1)
unnamed: J16.3 (D+), U10.3 (I/O2)
unnamed: R44.2, SW1.2
OEN: R49.2, U1.1 (G1), U1.19 (G2), U3.1 (G1), U3.19 (G2), U6.1 (G1), U6.19 (G2), U8.76 (PK1)
PDI_CLK: J11.5, R33.2, U8.90 (~RESET/PDI_CLK)
PDI_DATA: J11.1, U8.89 (PDI_DATA)
POWER_S: U3.2 (A0), U8.30 (PD5)
TX1: R45.2, U6.12 (Y6)
TX2: R40.2, U6.14 (Y4)
TX3: R35.2, U6.16 (Y2)
TX4: R29.2, U6.18 (Y0)
TX5: R20.2, U3.12 (Y6)
TX6: R12.2, U3.14 (Y4)
TX7: R4.2, U3.16 (Y2)
UARTC0_RX: R2.2, U2.7 (VO1), U8.17 (PC2)
UARTC0_SRX: U1.6 (A4), U8.68 (PJ3)
UARTC0_STX: U6.9 (A7), U8.97 (PA2)
UARTC0_TX: U6.8 (A6), U8.18 (PC3)
UARTC1_RX: R6.2, U2.6 (VO2), U8.21 (PC6)
UARTC1_SRX: U1.7 (A5), U8.67 (PJ2)
UARTC1_STX: U6.7 (A5), U8.98 (PA3)
UARTC1_TX: U6.6 (A4), U8.22 (PC7)
UARTD0_RX: R22.2, U4.7 (VO1), U8.27 (PD2)
UARTD0_SRX: U1.8 (A6), U8.66 (PJ1)
UARTD0_STX: U6.5 (A3), U8.99 (PA4)
UARTD0_TX: U6.4 (A2), U8.28 (PD3)
UARTE0_RX: R25.2, U4.6 (VO2), U8.37 (PE2)
UARTE0_SRX: U1.9 (A7), U8.65 (PJ0)
UARTE0_STX: U6.3 (A1), U8.100 (PA5)
UARTE0_TX: U6.2 (A0), U8.38 (PE3)
UARTE1_RX: R38.2, U7.7 (VO1), U8.41 (PE6)
UARTE1_SRX: U1.2 (A0), U8.72 (PJ7)
UARTE1_STX: U3.9 (A7), U8.26 (PD1)
UARTE1_TX: U3.8 (A6), U8.42 (PE7)
UARTF0_RX: R39.2, U7.6 (VO2), U8.47 (PF2)
UARTF0_SRX: U1.3 (A1), U8.71 (PJ6)
UARTF0_STX: U3.7 (A5), U8.25 (PD0)
UARTF0_TX: U3.6 (A4), U8.48 (PF3)
UARTF1_RX: R48.2, U8.51 (PF6), U9.7 (VO1)
UARTF1_SRX: U1.4 (A2), U8.70 (PJ5)
UARTF1_STX: U3.5 (A3), U8.50 (PF5)
UARTF1_TX: U3.4 (A2), U8.52 (PF7)
USB_SRX: U1.5 (A3), U8.69 (PJ4)
USB_STX: U3.3 (A1), U8.29 (PD4)

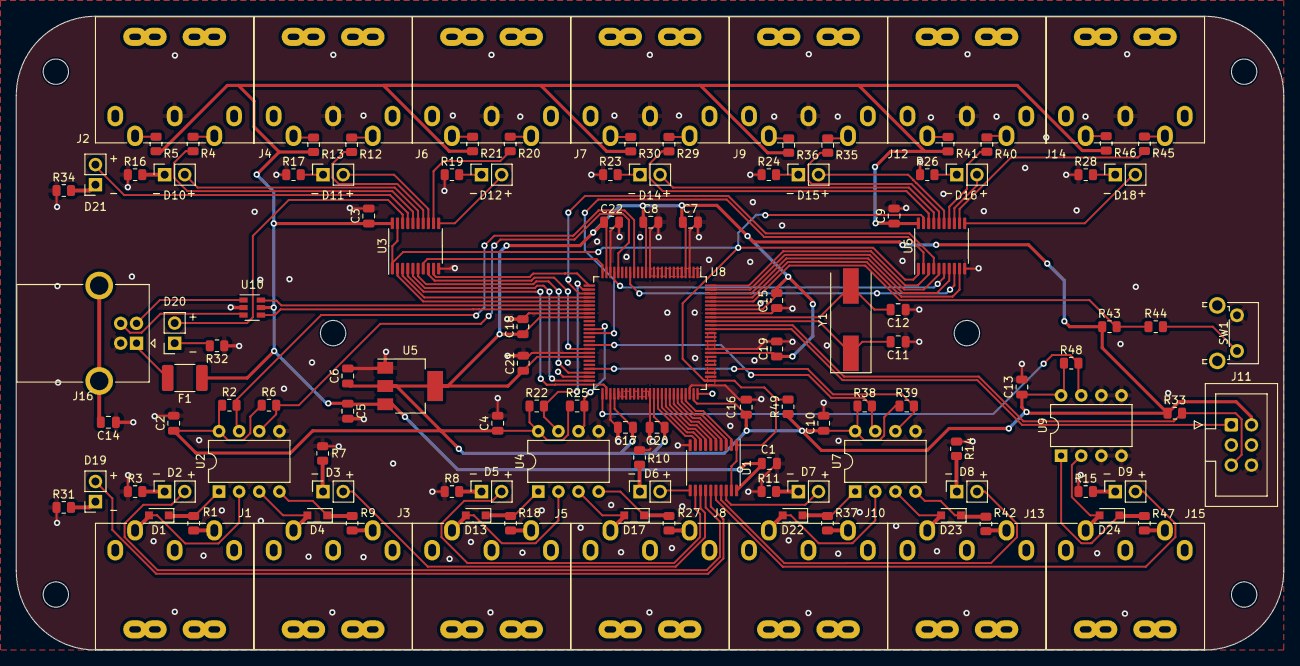
[picture p8: board midi_router_x7.kicad_pcb from above]

Board: 2 copper layers, 160.0 x 80.0 mm, 130 parts (0 on the bottom side), 123 nets.
