mar0x/midi_router/kicad/x4/midi_router_x4.kicad_pcb

## KiCad design kicad/x4/midi_router_x4.kicad_pcb (2024-06-15)

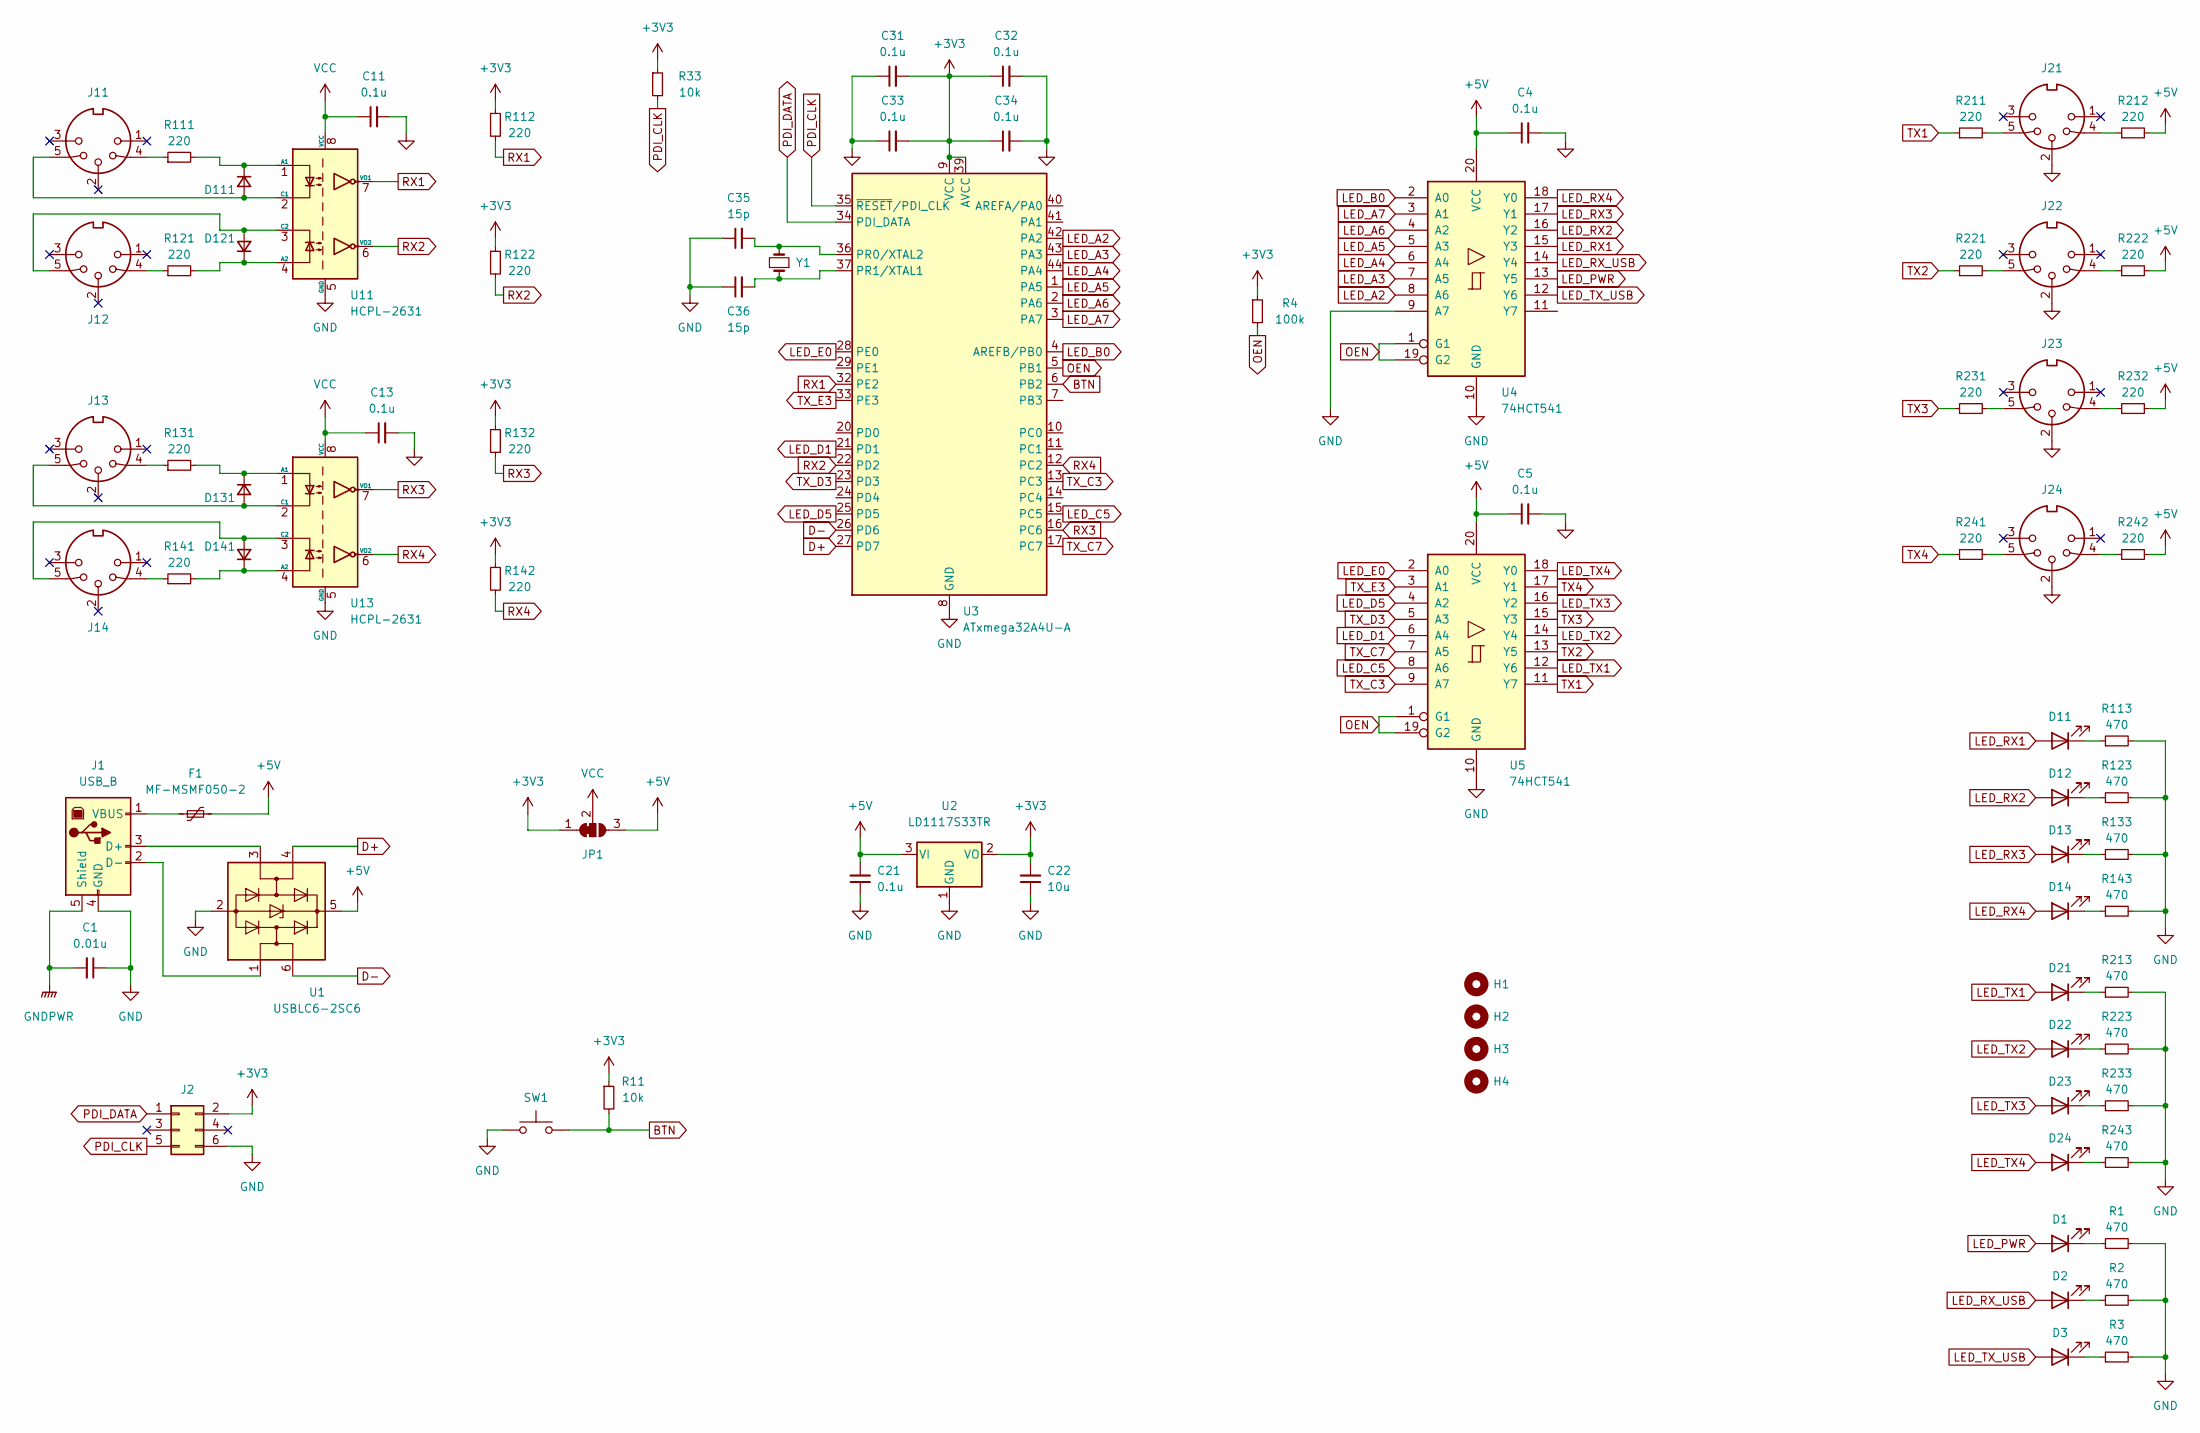
[picture p9: schematic midi_router_x4.kicad_sch]

Parts:
C1: 0.01u; C_0805_2012Metric_Pad1.18x1.45mm_HandSolder
C4, C5, C11, C13, C21, C31, C32, C33, C34: 0.1u; C_0805_2012Metric_Pad1.18x1.45mm_HandSolder
C22: 10u; C_0805_2012Metric_Pad1.18x1.45mm_HandSolder
C35, C36: 15p; C_0805_2012Metric_Pad1.18x1.45mm_HandSolder
D1, D2, D3, D11, D12, D13, D14, D21, D22, D23, D24: LED; PinSocket_1x02_P2.54mm_Vertical
D111, D121, D131, D141: D_Small; D_SOD-323_HandSoldering
F1: MF-MSMF050-2; Fuse_1812_4532Metric_Pad1.30x3.40mm_HandSolder
H1, H2, H3, H4: MountingHole; MountingHole_3.2mm_M3_DIN965
J1: USB_B; USB_B_OST_USB-B1HSxx_Horizontal
J2: Conn_02x03_Odd_Even; IDC-Header_2x03_P2.54mm_Vertical
J11, J12, J13, J14, J21, J22, J23, J24: DIN-5_180degree; DIN5MIDI-OOTDTY
JP1: SolderJumper_3_Bridged12; SolderJumper-3_P1.3mm_Bridged2Bar12_Pad1.0x1.5mm
R1, R2, R3, R113, R123, R133, R143, R213, R223, R233, R243: 470; R_0805_2012Metric_Pad1.20x1.40mm_HandSolder
R4: 100k; R_0805_2012Metric_Pad1.20x1.40mm_HandSolder
R11, R33: 10k; R_0805_2012Metric_Pad1.20x1.40mm_HandSolder
R111, R112, R121, R122, R131, R132, R141, R142, R211, R212, R221, R222, R231, R232, R241, R242: 220; R_0805_2012Metric_Pad1.20x1.40mm_HandSolder
SW1: SW_Push; SW_Tactile_SPST_Angled_PTS645Vx58-2LFS
U1: USBLC6-2SC6; SOT-23-6_Handsoldering
U2: LD1117S33TR; SOT-223-3_TabPin2
U3: ATxmega32A4U-A; TQFP-44_10x10mm_P0.8mm
U4, U5: 74HCT541; TSSOP-20_4.4x6.5mm_P0.65mm
U11, U13: HCPL-2631; DIP-8_W7.62mm
Y1: Crystal_Small; Crystal_SMD_HC49-SD

Connections:
+3V3: C22.2, C31.2, C32.1, C33.2, C34.1, J2.2, JP1.1 (A), R4.1, R11.1, R33.1, R112.1, R122.1, R132.1, R142.1, U2.2 (VO), U3.9 (VCC), U3.19 (VCC), U3.31 (VCC), U3.39 (AVCC)
+5V: C4.1, C5.1, C21.2, F1.2, JP1.3 (B), R212.2, R222.2, R232.2, R242.2, U1.5 (VBUS), U2.3 (VI), U4.20 (VCC), U5.20 (VCC)
BTN: R11.2, SW1.2, U3.6 (PB2)
D+: U1.4 (I/O2), U3.27 (PD7)
D-: U1.6 (I/O1), U3.26 (PD6)
GND: C1.1, C4.2, C5.2, C11.2, C13.2, C21.1, C22.1, C31.1, C32.2, C33.1, C34.2, C35.1, C36.1, J1.4 (GND), J2.6, J21.2, J22.2, J23.2, J24.2, R1.2, R2.2, R3.2, R113.2, R123.2, R133.2, R143.2, R213.2, R223.2, R233.2, R243.2, SW1.1, U1.2 (GND), U2.1 (GND), U3.8 (GND), U3.18 (GND), U3.30 (GND), U3.38 (GND), U4.9 (A7), U4.10 (GND), U5.10 (GND), U11.5 (GND), U13.5 (GND)
GNDPWR: C1.2, J1.5 (Shield)
LED_A2: U3.42 (PA2), U4.8 (A6)
LED_A3: U3.43 (PA3), U4.7 (A5)
LED_A4: U3.44 (PA4), U4.6 (A4)
LED_A5: U3.1 (PA5), U4.5 (A3)
LED_A6: U3.2 (PA6), U4.4 (A2)
LED_A7: U3.3 (PA7), U4.3 (A1)
LED_B0: U3.4 (AREFB/PB0), U4.2 (A0)
LED_C5: U3.15 (PC5), U5.8 (A6)
LED_D1: U3.21 (PD1), U5.6 (A4)
LED_D5: U3.25 (PD5), U5.4 (A2)
LED_E0: U3.28 (PE0), U5.2 (A0)
LED_PWR: D1.2 (A), U4.13 (Y5)
LED_RX1: D11.2 (A), U4.15 (Y3)
LED_RX2: D12.2 (A), U4.16 (Y2)
LED_RX3: D13.2 (A), U4.17 (Y1)
LED_RX4: D14.2 (A), U4.18 (Y0)
LED_RX_USB: D2.2 (A), U4.14 (Y4)
LED_TX1: D21.2 (A), U5.12 (Y6)
LED_TX2: D22.2 (A), U5.14 (Y4)
LED_TX3: D23.2 (A), U5.16 (Y2)
LED_TX4: D24.2 (A), U5.18 (Y0)
LED_TX_USB: D3.2 (A), U4.12 (Y6)
unnamed: C35.2, U3.36 (PR0/XTAL2), Y1.2
unnamed: C36.2, U3.37 (PR1/XTAL1), Y1.1
unnamed: D1.1 (K), R1.1
unnamed: D2.1 (K), R2.1
unnamed: D3.1 (K), R3.1
unnamed: D11.1 (K), R113.1
unnamed: D12.1 (K), R123.1
unnamed: D13.1 (K), R133.1
unnamed: D14.1 (K), R143.1
unnamed: D21.1 (K), R213.1
unnamed: D22.1 (K), R223.1
unnamed: D23.1 (K), R233.1
unnamed: D24.1 (K), R243.1
unnamed: D111.1 (K), R111.2, U11.1 (A1)
unnamed: D111.2 (A), J11.5, U11.2 (C1)
unnamed: D121.1 (K), R121.2, U11.4 (A2)
unnamed: D121.2 (A), J12.5, U11.3 (C2)
unnamed: D131.1 (K), R131.2, U13.1 (A1)
unnamed: D131.2 (A), J13.5, U13.2 (C1)
unnamed: D141.1 (K), R141.2, U13.4 (A2)
unnamed: D141.2 (A), J14.5, U13.3 (C2)
unnamed: F1.1, J1.1 (VBUS)
unnamed: J1.2 (D-), U1.1 (I/O1)
unnamed: J1.3 (D+), U1.3 (I/O2)
unnamed: J11.4, R111.1
unnamed: J12.4, R121.1
unnamed: J13.4, R131.1
unnamed: J14.4, R141.1
unnamed: J21.4, R212.1
unnamed: J21.5, R211.2
unnamed: J22.4, R222.1
unnamed: J22.5, R221.2
unnamed: J23.4, R232.1
unnamed: J23.5, R231.2
unnamed: J24.4, R242.1
unnamed: J24.5, R241.2
OEN: R4.2, U3.5 (PB1), U4.1 (G1), U4.19 (G2), U5.1 (G1), U5.19 (G2)
PDI_CLK: J2.5, R33.2, U3.35 (~RESET/PDI_CLK)
PDI_DATA: J2.1, U3.34 (PDI_DATA)
RX1: R112.2, U3.32 (PE2), U11.7 (VO1)
RX2: R122.2, U3.22 (PD2), U11.6 (VO2)
RX3: R132.2, U3.16 (PC6), U13.7 (VO1)
RX4: R142.2, U3.12 (PC2), U13.6 (VO2)
TX1: R211.1, U5.11 (Y7)
TX2: R221.1, U5.13 (Y5)
TX3: R231.1, U5.15 (Y3)
TX4: R241.1, U5.17 (Y1)
TX_C3: U3.13 (PC3), U5.9 (A7)
TX_C7: U3.17 (PC7), U5.7 (A5)
TX_D3: U3.23 (PD3), U5.5 (A3)
TX_E3: U3.33 (PE3), U5.3 (A1)
VCC: C11.1, C13.1, JP1.2 (C), U11.8 (VCC), U13.8 (VCC)

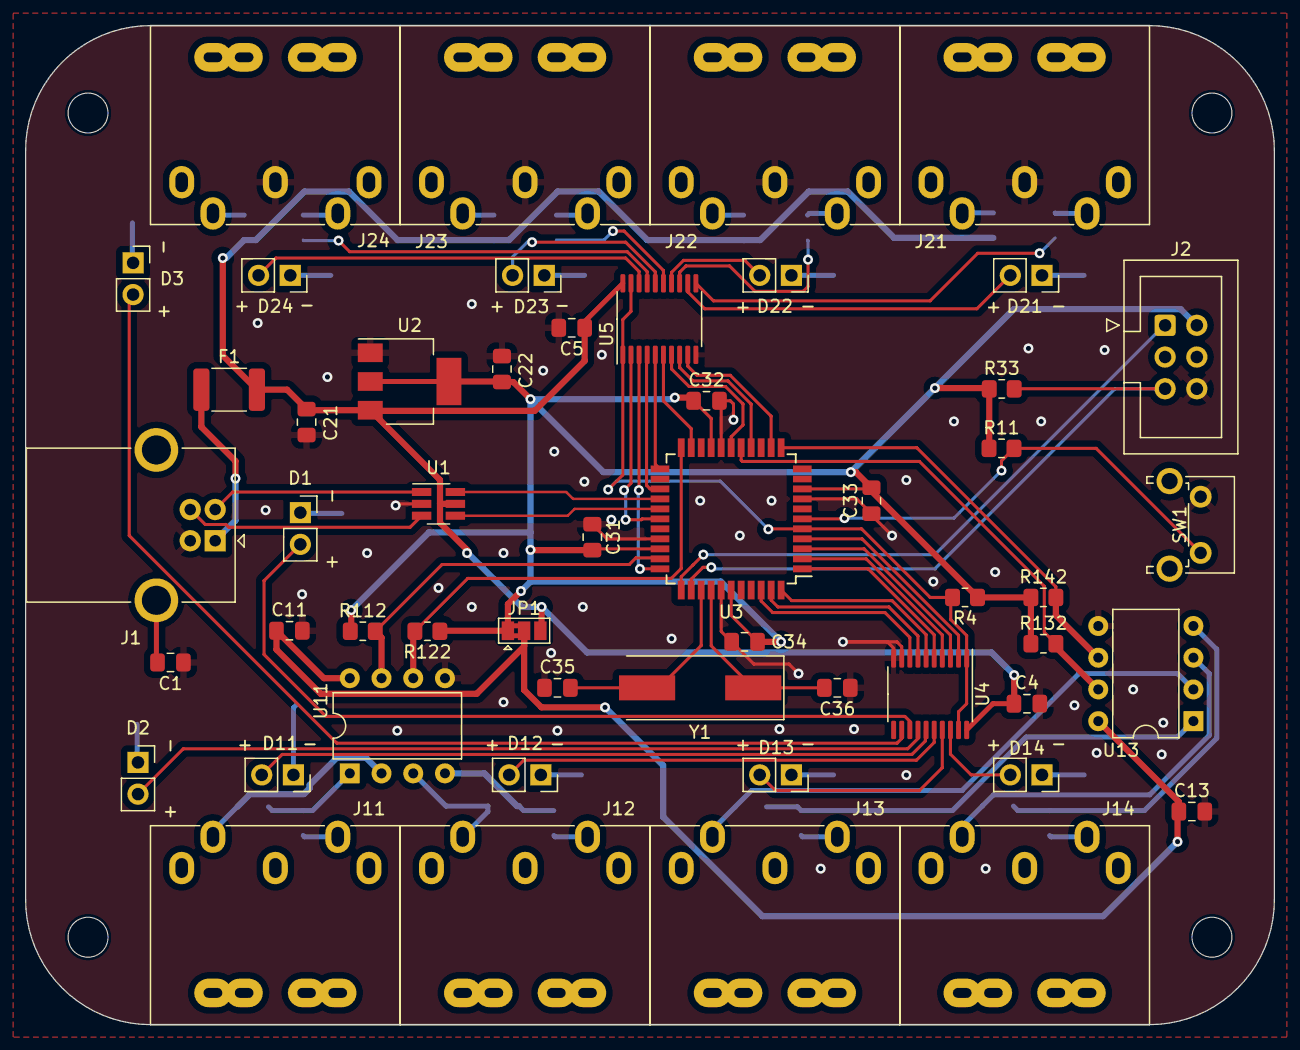
[picture p10: board midi_router_x4.kicad_pcb from above]

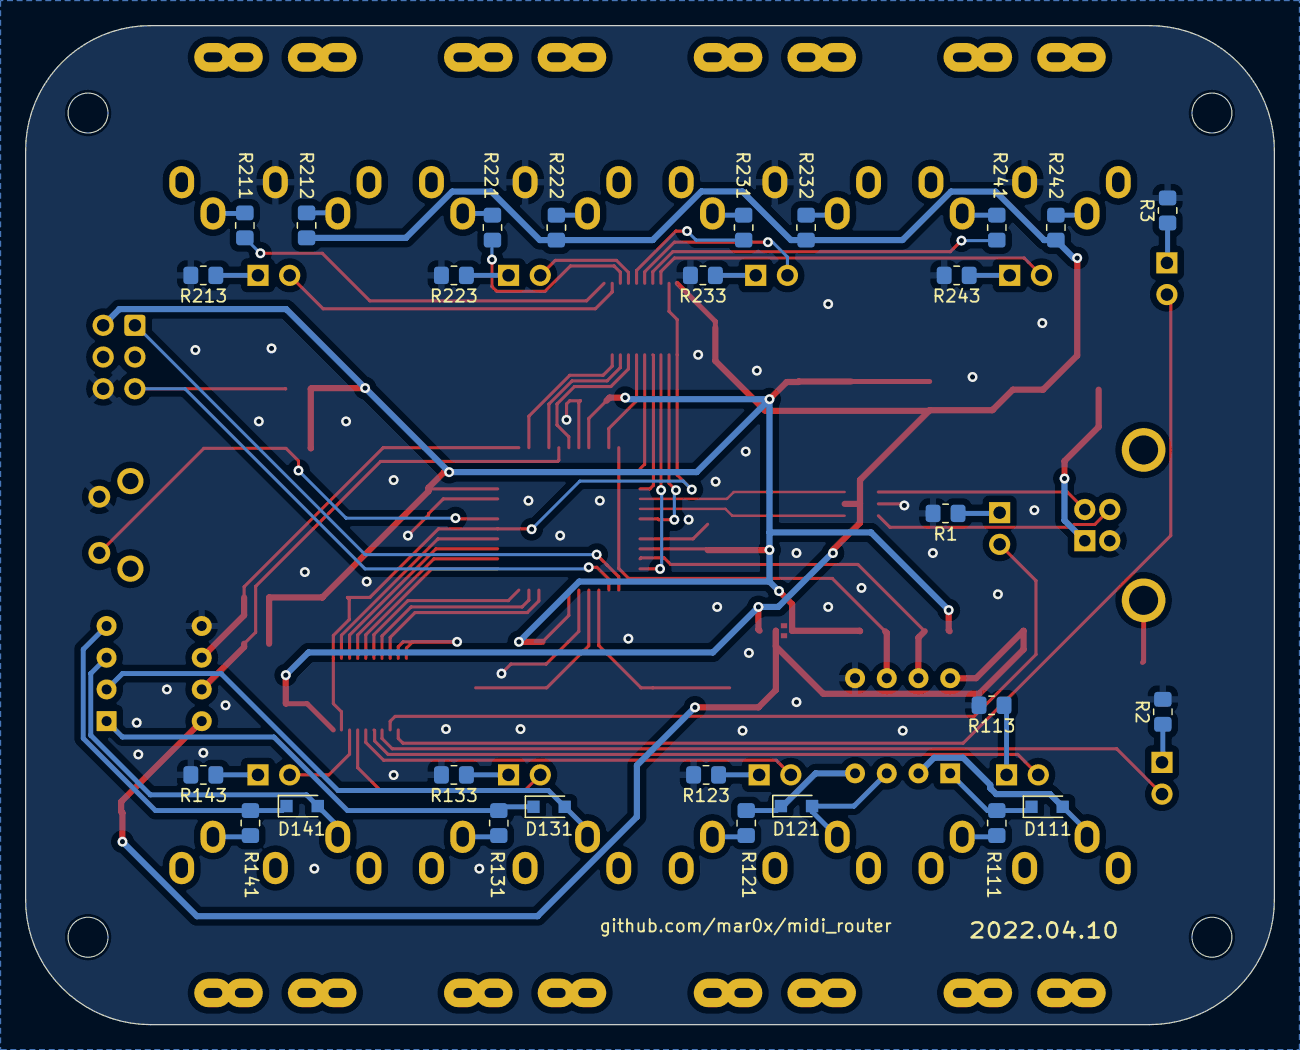
[picture p11: board midi_router_x4.kicad_pcb from below]

Board: 2 copper layers, 100.0 x 80.0 mm, 83 parts (27 on the bottom side), 81 nets.
