mar0x/midi_router/kicad/x7-rack/led/midi_router_x7_led.kicad_pcb

## KiCad design kicad/x7-rack/led/midi_router_x7_led.kicad_pcb (2024-06-15)

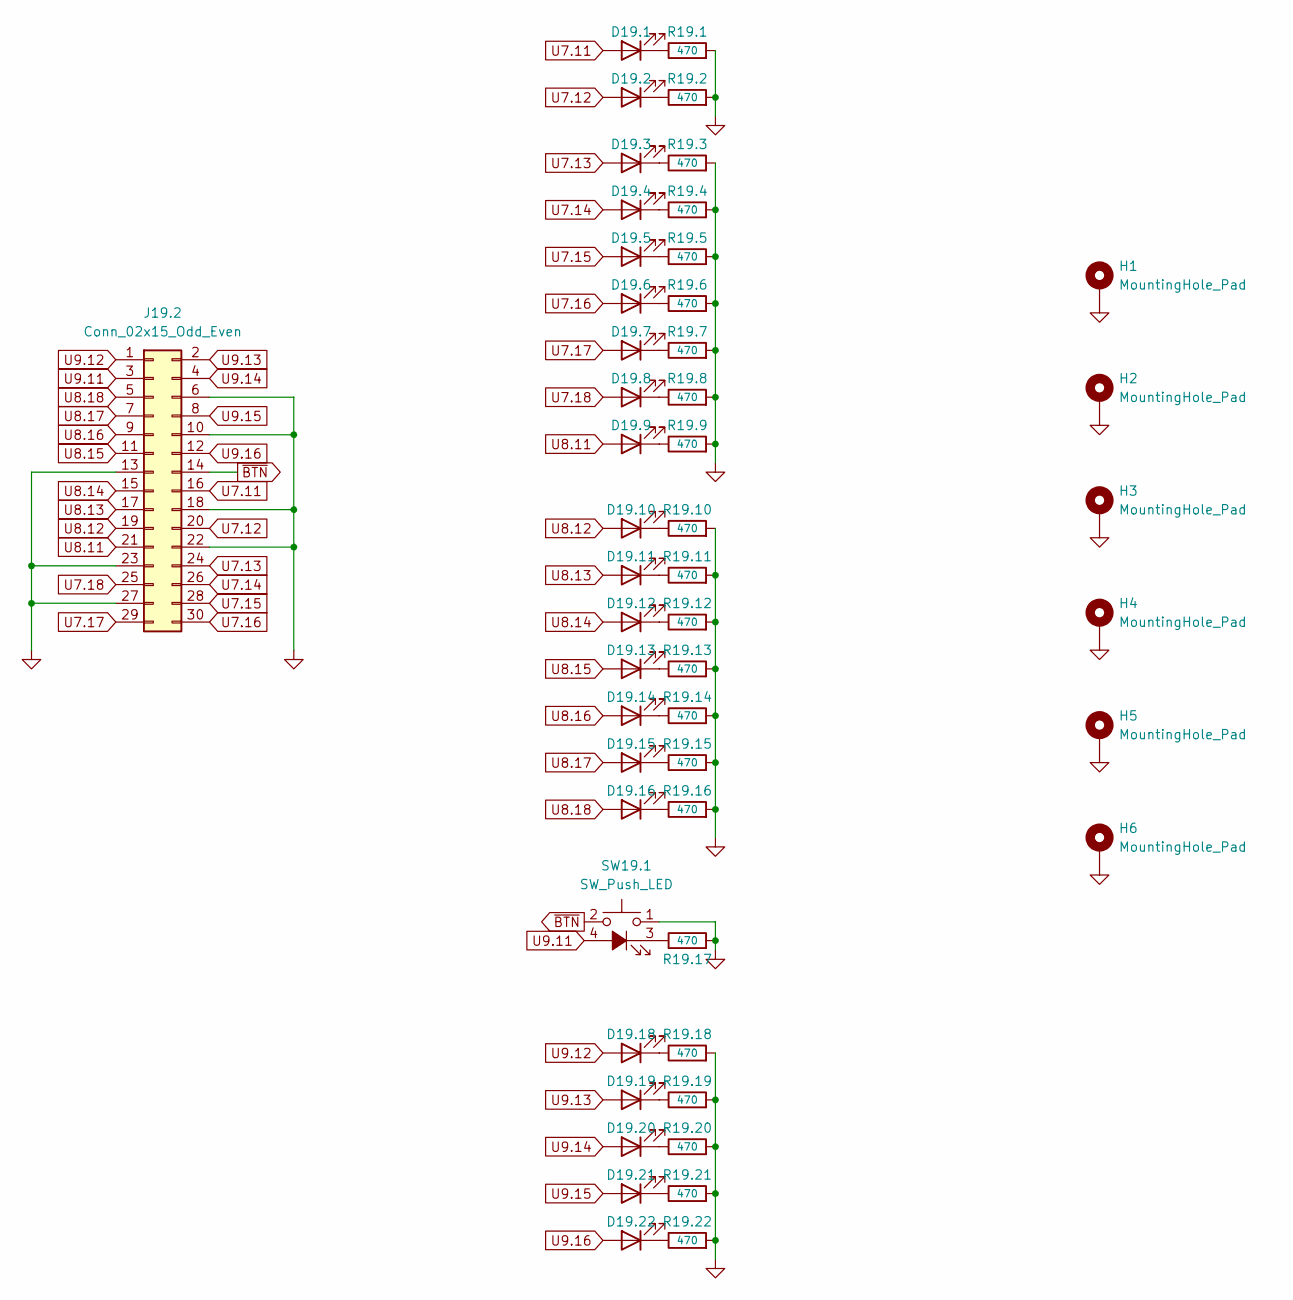
[picture p12: schematic midi_router_x7_led.kicad_sch]

Parts:
D19.1, D19.2, D19.3, D19.4, D19.5, D19.6, D19.7, D19.8, D19.9, D19.10, D19.11, D19.12, D19.13, D19.14, D19.15, D19.16, D19.18, D19.19, D19.20, D19.21, D19.22: LED; LED_Rectangular_W5.0mm_H2.0mm
H1, H2, H3, H4, H5, H6: MountingHole_Pad; MountingHole_3.2mm_M3_Pad_Via
J19.2: Conn_02x15_Odd_Even; IDC-Header_2x15_P2.54mm_Vertical
R19.1, R19.2, R19.3, R19.4, R19.5, R19.6, R19.7, R19.8, R19.9, R19.10, R19.11, R19.12, R19.13, R19.14, R19.15, R19.16, R19.17, R19.18, R19.19, R19.20, R19.21, R19.22: 470; R_0805_2012Metric
SW19.1: SW_Push_LED; SW_PUSH_6mm

Connections:
GND: H1.1, H2.1, H3.1, H4.1, H5.1, H6.1, J19.2.6, J19.2.10, J19.2.13, J19.2.18, J19.2.22, J19.2.23, J19.2.27, R19.1.2, R19.2.2, R19.3.2, R19.4.2, R19.5.2, R19.6.2, R19.7.2, R19.8.2, R19.9.2, R19.10.2, R19.11.2, R19.12.2, R19.13.2, R19.14.2, R19.15.2, R19.16.2, R19.17.2, R19.18.2, R19.19.2, R19.20.2, R19.21.2, R19.22.2, SW19.1.1
unnamed: D19.1.1 (K), R19.1.1
unnamed: D19.2.1 (K), R19.2.1
unnamed: D19.3.1 (K), R19.3.1
unnamed: D19.4.1 (K), R19.4.1
unnamed: D19.5.1 (K), R19.5.1
unnamed: D19.6.1 (K), R19.6.1
unnamed: D19.7.1 (K), R19.7.1
unnamed: D19.8.1 (K), R19.8.1
unnamed: D19.9.1 (K), R19.9.1
unnamed: D19.10.1 (K), R19.10.1
unnamed: D19.11.1 (K), R19.11.1
unnamed: D19.12.1 (K), R19.12.1
unnamed: D19.13.1 (K), R19.13.1
unnamed: D19.14.1 (K), R19.14.1
unnamed: D19.15.1 (K), R19.15.1
unnamed: D19.16.1 (K), R19.16.1
unnamed: D19.18.1 (K), R19.18.1
unnamed: D19.19.1 (K), R19.19.1
unnamed: D19.20.1 (K), R19.20.1
unnamed: D19.21.1 (K), R19.21.1
unnamed: D19.22.1 (K), R19.22.1
unnamed: R19.17.1, SW19.1.3 (K)
U7.11: D19.1.2 (A), J19.2.16
U7.12: D19.2.2 (A), J19.2.20
U7.13: D19.3.2 (A), J19.2.24
U7.14: D19.4.2 (A), J19.2.26
U7.15: D19.5.2 (A), J19.2.28
U7.16: D19.6.2 (A), J19.2.30
U7.17: D19.7.2 (A), J19.2.29
U7.18: D19.8.2 (A), J19.2.25
U8.11: D19.9.2 (A), J19.2.21
U8.12: D19.10.2 (A), J19.2.19
U8.13: D19.11.2 (A), J19.2.17
U8.14: D19.12.2 (A), J19.2.15
U8.15: D19.13.2 (A), J19.2.11
U8.16: D19.14.2 (A), J19.2.9
U8.17: D19.15.2 (A), J19.2.7
U8.18: D19.16.2 (A), J19.2.5
U9.11: J19.2.3, SW19.1.4 (A)
U9.12: D19.18.2 (A), J19.2.1
U9.13: D19.19.2 (A), J19.2.2
U9.14: D19.20.2 (A), J19.2.4
U9.15: D19.21.2 (A), J19.2.8
U9.16: D19.22.2 (A), J19.2.12
~BTN: J19.2.14, SW19.1.2

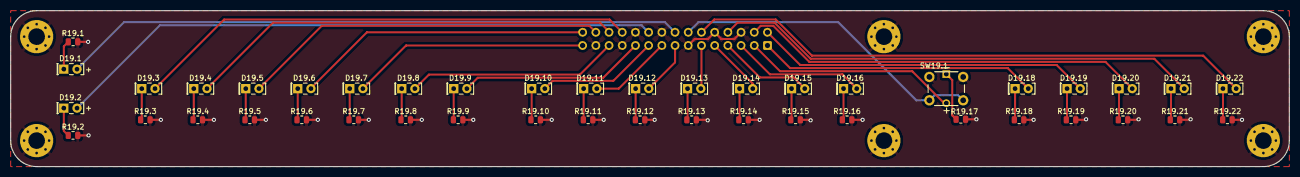
[picture p13: board midi_router_x7_led.kicad_pcb from above]

Board: 2 copper layers, 246.0 x 30.0 mm, 51 parts (1 on the bottom side), 46 nets.
