mar0x/midi_router/kicad/x7-rack/main/midi_router_x7_rack.kicad_pcb

## KiCad design kicad/x7-rack/main/midi_router_x7_rack.kicad_pcb (2024-06-15)

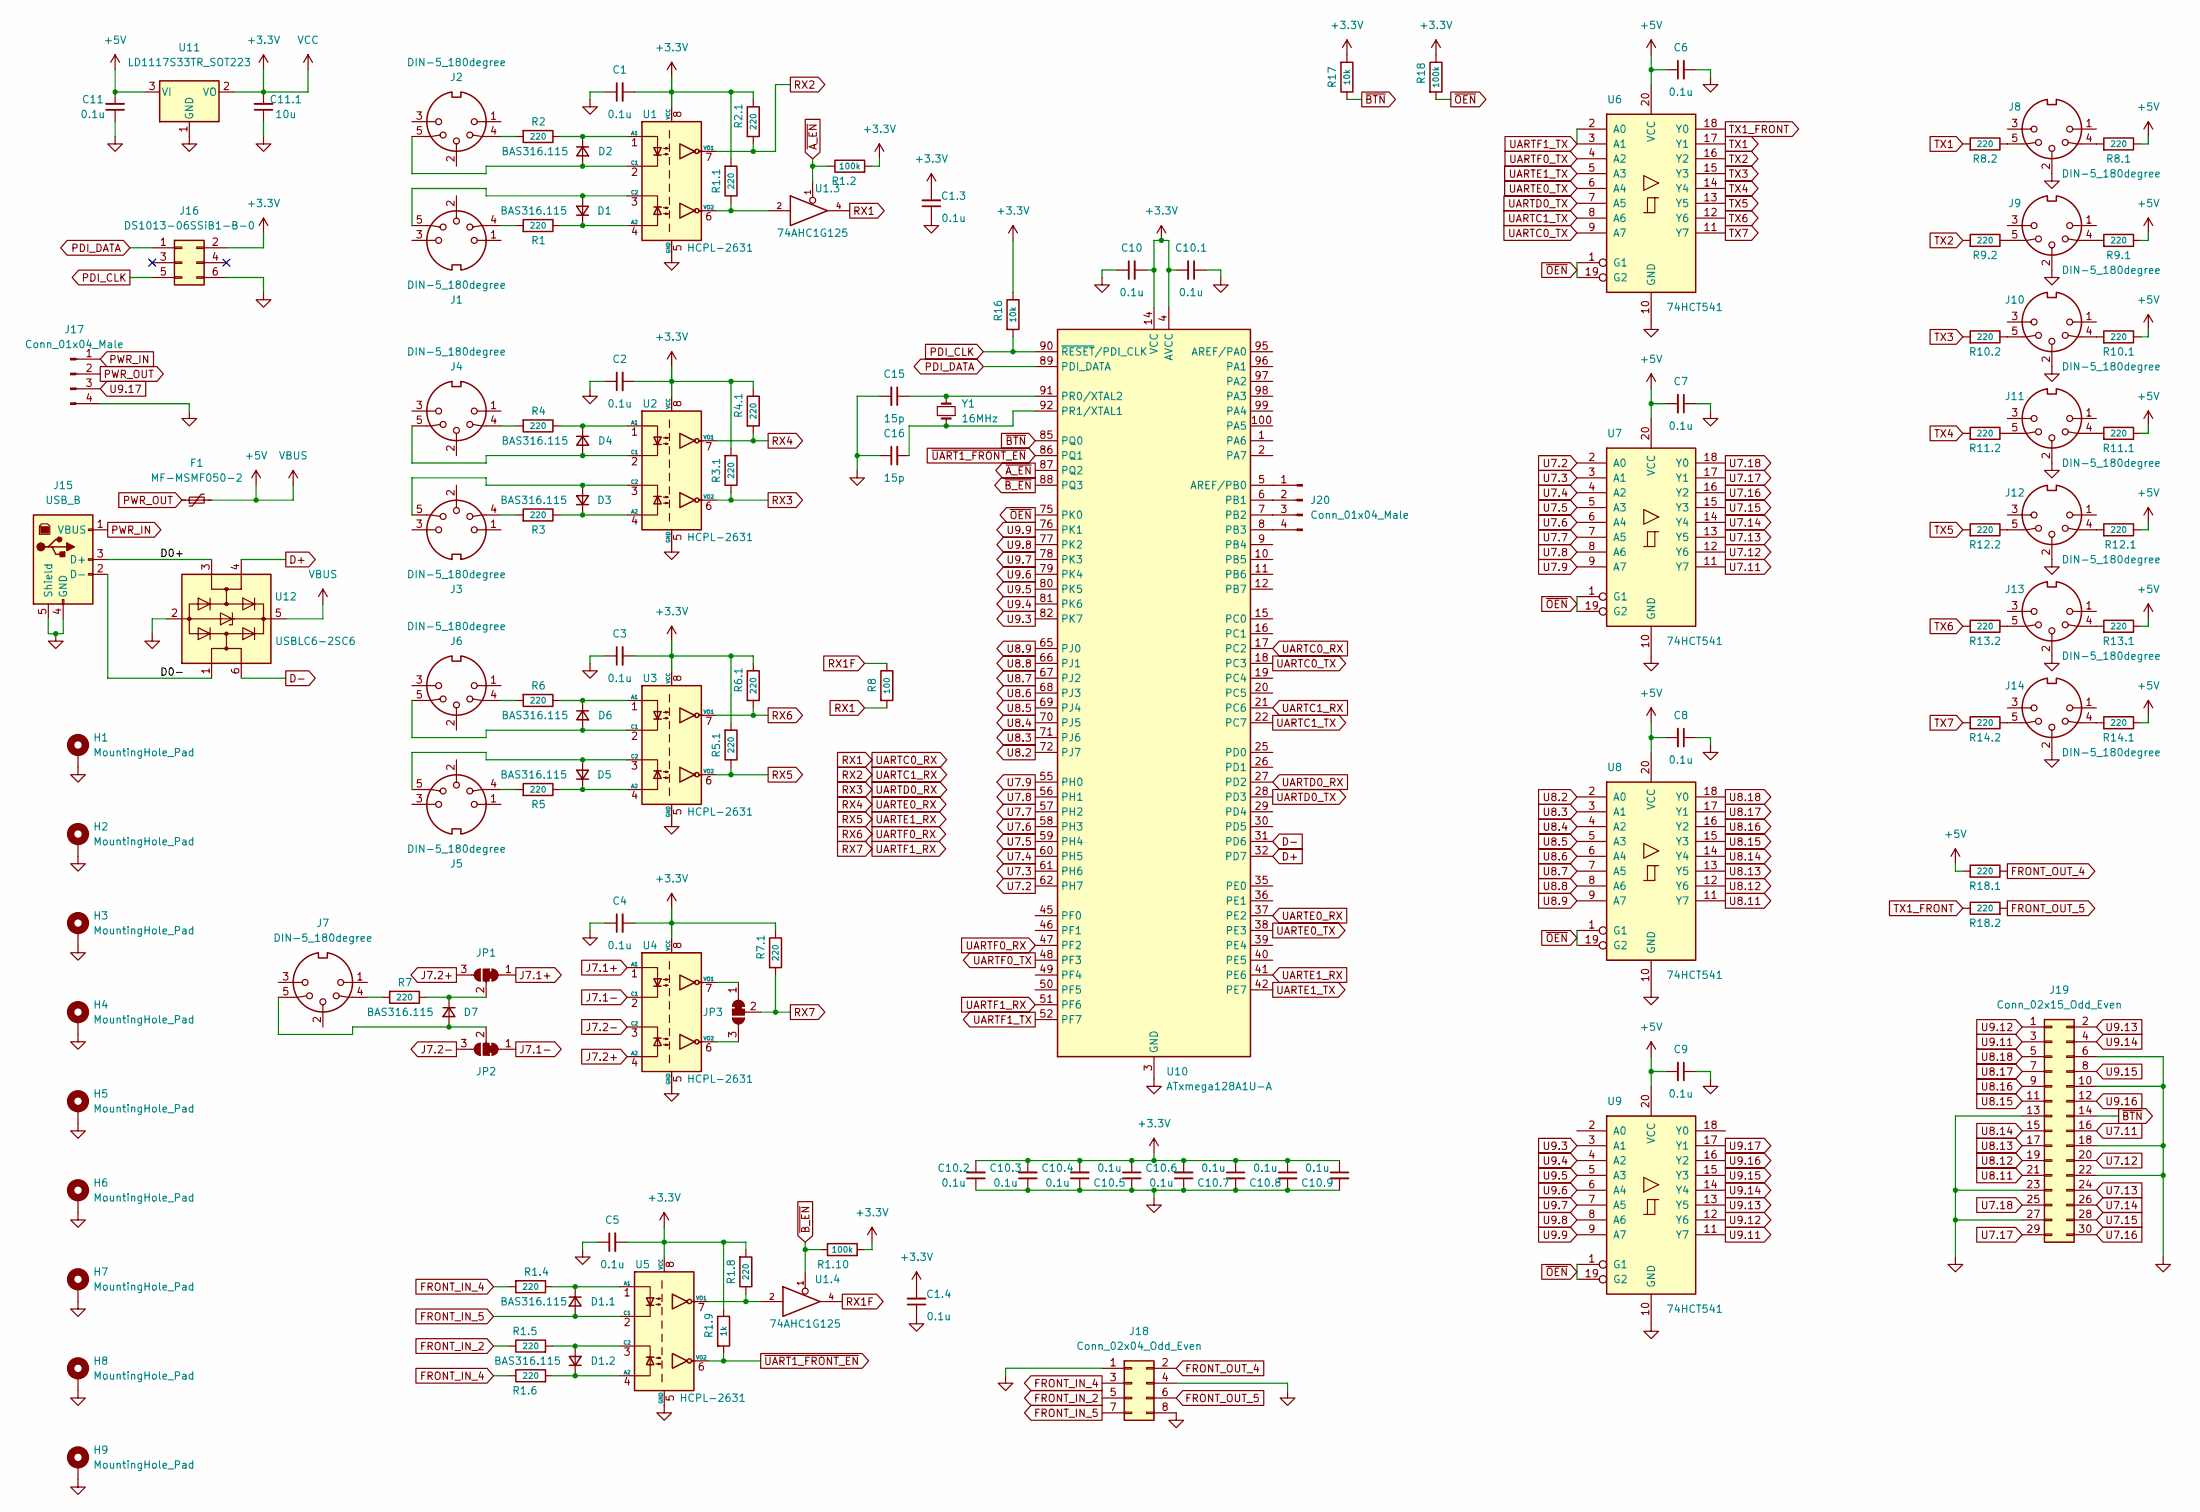
[picture p14: schematic midi_router_x7_rack.kicad_sch, MIDI Router x7 (Rack Edition)]

Parts:
C1, C1.3, C1.4, C2, C3, C4, C5, C6, C7, C8, C9, C10, C10.1, C10.2, C10.3, C10.4, C10.5, C10.6, C10.7, C10.8, C10.9, C11: 0.1u; C_0805_2012Metric
C11.1: 10u; C_0805_2012Metric
C15, C16: 15p; C_0805_2012Metric
D1, D1.1, D1.2, D2, D3, D4, D5, D6, D7: BAS316.115; D_SOD-323_HandSoldering
F1: MF-MSMF050-2; Fuse_1812_4532Metric
H1, H2, H3, H4, H5, H6, H7, H8, H9: MountingHole_Pad; MountingHole_3.2mm_M3_Pad_Via
J1, J2, J3, J4, J5, J6, J7, J8, J9, J10, J11, J12, J13, J14: DIN-5_180degree; DIN5MIDI-OOTDTY
J15: USB_B; USB_B_OST_USB-B1HSxx_Horizontal
J16: DS1013-06SSiB1-B-0; IDC-Header_2x03_P2.54mm_Vertical
J17: Conn_01x04_Male; JST_EH_B4B-EH-A_1x04_P2.50mm_Vertical
J18: Conn_02x04_Odd_Even; IDC-Header_2x04_P2.54mm_Vertical
J19: Conn_02x15_Odd_Even; IDC-Header_2x15_P2.54mm_Vertical
J20: Conn_01x04_Male; PinHeader_1x04_P2.54mm_Vertical
JP1, JP2, JP3: SolderJumper_3_Bridged12; SolderJumper-3_P1.3mm_Bridged12_RoundedPad1.0x1.5mm_NumberL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
R1, R1.1, R1.4, R1.5, R1.6, R1.8, R2, R2.1, R3, R3.1, R4, R4.1, R5, R5.1, R6, R6.1, R7, R7.1, R8.1, R8.2, R9.1, R9.2, R10.1, R10.2, R11.1, R11.2, R12.1, R12.2, R13.1, R13.2, R14.1, R14.2, R18.1, R18.2: 220; R_0805_2012Metric
R1.2, R1.10, R18: 100k; R_0805_2012Metric
R1.9: 1k; R_0805_2012Metric
R8: 100; R_0805_2012Metric
R16, R17: 10k; R_0805_2012Metric
U1, U2, U3, U4, U5: HCPL-2631; DIP-8_W7.62mm
U1.3, U1.4: 74AHC1G125; SOT-23-5
U6, U7, U8, U9: 74HCT541; TSSOP-20_4.4x6.5mm_P0.65mm
U10: ATxmega128A1U-A; TQFP-100_14x14mm_P0.5mm
U11: LD1117S33TR_SOT223; SOT-223-3_TabPin2
U12: USBLC6-2SC6; SOT-23-6
Y1: 16MHz; Crystal_SMD_HC49-SD

Connections:
+3V3: C1.2, C1.3.2, C1.4.2, C2.2, C3.2, C4.2, C5.2, C10.2, C10.1.2, C10.2.2, C10.3.2, C10.4.2, C10.5.1, C10.6.2, C10.7.1, C10.8.1, C10.9.1, C11.1.2, J16.2, R1.1.2, R1.2.2, R1.8.2, R1.9.1, R1.10.2, R2.1.1, R3.1.2, R4.1.1, R5.1.2, R6.1.1, R7.1.1, R16.1, R17.2, R18.1, U1.8 (VCC), U1.3.5 (VCC), U1.4.5 (VCC), U2.8 (VCC), U3.8 (VCC), U4.8 (VCC), U5.8 (VCC), U10.4 (AVCC), U10.14 (VCC), U10.24 (VCC), U10.34 (VCC), U10.44 (VCC), U10.54 (VCC), U10.64 (VCC), U10.74 (VCC), U10.83 (VCC), U10.94 (AVCC), U11.2 (VO)
+5V: C6.1, C7.2, C8.2, C9.2, C11.2, F1.2, R8.1.1, R9.1.1, R10.1.1, R11.1.1, R12.1.1, R13.1.1, R14.1.1, R18.1.2, U6.20 (VCC), U7.20 (VCC), U8.20 (VCC), U9.20 (VCC), U11.3 (VI), U12.5 (VBUS)
/D0+: J15.3 (D+), U12.3 (I/O2)
/D0-: J15.2 (D-), U12.1 (I/O1)
D+: U10.32 (PD7), U12.4 (I/O2)
D-: U10.31 (PD6), U12.6 (I/O1)
FRONT_IN_2: J18.5, R1.5.1
FRONT_IN_4: J18.3, R1.4.2, R1.6.1
FRONT_IN_5: D1.1.2 (A), J18.7, U5.2 (C1)
FRONT_OUT_4: J18.2, R18.1.1
FRONT_OUT_5: J18.6, R18.2.2
GND: C1.1, C1.3.1, C1.4.1, C2.1, C3.1, C4.1, C5.1, C6.2, C7.1, C8.1, C9.1, C10.1, C10.1.1, C10.2.1, C10.3.1, C10.4.1, C10.5.2, C10.6.1, C10.7.2, C10.8.2, C10.9.2, C11.1, C11.1.1, C15.2, C16.1, H1.1, H2.1, H3.1, H4.1, H5.1, H6.1, H7.1, H8.1, H9.1, J8.2, J9.2, J10.2, J11.2, J12.2, J13.2, J14.2, J15.4 (GND), J15.5 (Shield), J16.6, J17.4, J18.1, J18.4, J18.8, J19.6, J19.10, J19.13, J19.18, J19.22, J19.23, J19.27, U1.5 (GND), U1.3.3 (GND), U1.4.3 (GND), U2.5 (GND), U3.5 (GND), U4.5 (GND), U5.5 (GND), U6.10 (GND), U7.10 (GND), U8.10 (GND), U9.10 (GND), U10.3 (GND), U10.13 (GND), U10.23 (GND), U10.33 (GND), U10.43 (GND), U10.53 (GND), U10.63 (GND), U10.73 (GND), U10.84 (GND), U10.93 (GND), U11.1 (GND), U12.2 (GND)
J7.1+: JP1.1 (A), U4.1 (A1)
J7.1-: JP2.1 (A), U4.2 (C1)
J7.2+: JP1.3 (B), U4.4 (A2)
J7.2-: JP2.3 (B), U4.3 (C2)
unnamed: D1.2 (A), J1.5, U1.3 (C2)
unnamed: D1.1 (K), R1.1, U1.4 (A2)
unnamed: D1.1.1 (K), R1.4.1, U5.1 (A1)
unnamed: D1.2.2 (A), R1.5.2, U5.3 (C2)
unnamed: D1.2.1 (K), R1.6.2, U5.4 (A2)
unnamed: D2.2 (A), J2.5, U1.2 (C1)
unnamed: D2.1 (K), R2.1, U1.1 (A1)
unnamed: D3.2 (A), J3.5, U2.3 (C2)
unnamed: D3.1 (K), R3.1, U2.4 (A2)
unnamed: D4.2 (A), J4.5, U2.2 (C1)
unnamed: D4.1 (K), R4.1, U2.1 (A1)
unnamed: D5.2 (A), J5.5, U3.3 (C2)
unnamed: D5.1 (K), R5.1, U3.4 (A2)
unnamed: D6.2 (A), J6.5, U3.2 (C1)
unnamed: D6.1 (K), R6.1, U3.1 (A1)
unnamed: D7.2 (A), J7.5, JP2.2 (C)
unnamed: D7.1 (K), JP1.2 (C), R7.1
unnamed: J1.4, R1.2
unnamed: J2.4, R2.2
unnamed: J3.4, R3.2
unnamed: J4.4, R4.2
unnamed: J5.4, R5.2
unnamed: J6.4, R6.2
unnamed: J7.4, R7.2
unnamed: J8.4, R8.1.2
unnamed: J8.5, R8.2.1
unnamed: J9.4, R9.1.2
unnamed: J9.5, R9.2.1
unnamed: J10.4, R10.1.2
unnamed: J10.5, R10.2.1
unnamed: J11.4, R11.1.2
unnamed: J11.5, R11.2.1
unnamed: J12.4, R12.1.2
unnamed: J12.5, R12.2.1
unnamed: J13.4, R13.1.2
unnamed: J13.5, R13.2.1
unnamed: J14.4, R14.1.2
unnamed: J14.5, R14.2.1
unnamed: J20.1, U10.5 (AREF/PB0)
unnamed: J20.2, U10.6 (PB1)
unnamed: J20.3, U10.7 (PB2)
unnamed: J20.4, U10.8 (PB3)
unnamed: JP3.1 (A), U4.7 (VO1)
unnamed: JP3.3 (B), U4.6 (VO2)
unnamed: R1.1.1, U1.6 (VO2), U1.3.2
unnamed: R1.8.1, U1.4.2, U5.7 (VO1)
unnamed: C15.1, U10.91 (PR0/XTAL2), Y1.2
unnamed: C16.2, U10.92 (PR1/XTAL1), Y1.1
PDI_CLK: J16.5, R16.2, U10.90 (~RESET/PDI_CLK)
PDI_DATA: J16.1, U10.89 (PDI_DATA)
PWR_IN: J15.1 (VBUS), J17.1
PWR_OUT: F1.1, J17.2
RX1: R8.2, U1.3.4, U10.17 (PC2)
RX1F: R8.1, U1.4.4
RX2: R2.1.2, U1.7 (VO1), U10.21 (PC6)
RX3: R3.1.1, U2.6 (VO2), U10.27 (PD2)
RX4: R4.1.2, U2.7 (VO1), U10.37 (PE2)
RX5: R5.1.1, U3.6 (VO2), U10.41 (PE6)
RX6: R6.1.2, U3.7 (VO1), U10.47 (PF2)
RX7: JP3.2 (C), R7.1.2, U10.51 (PF6)
TX1: R8.2.2, U6.17 (Y1)
TX1_FRONT: R18.2.1, U6.18 (Y0)
TX2: R9.2.2, U6.16 (Y2)
TX3: R10.2.2, U6.15 (Y3)
TX4: R11.2.2, U6.14 (Y4)
TX5: R12.2.2, U6.13 (Y5)
TX6: R13.2.2, U6.12 (Y6)
TX7: R14.2.2, U6.11 (Y7)
U7.2: U7.2 (A0), U10.62 (PH7)
U7.3: U7.3 (A1), U10.61 (PH6)
U7.4: U7.4 (A2), U10.60 (PH5)
U7.5: U7.5 (A3), U10.59 (PH4)
U7.6: U7.6 (A4), U10.58 (PH3)
U7.7: U7.7 (A5), U10.57 (PH2)
U7.8: U7.8 (A6), U10.56 (PH1)
U7.9: U7.9 (A7), U10.55 (PH0)
U7.11: J19.16, U7.11 (Y7)
U7.12: J19.20, U7.12 (Y6)
U7.13: J19.24, U7.13 (Y5)
U7.14: J19.26, U7.14 (Y4)
U7.15: J19.28, U7.15 (Y3)
U7.16: J19.30, U7.16 (Y2)
U7.17: J19.29, U7.17 (Y1)
U7.18: J19.25, U7.18 (Y0)
U8.2: U8.2 (A0), U10.72 (PJ7)
U8.3: U8.3 (A1), U10.71 (PJ6)
U8.4: U8.4 (A2), U10.70 (PJ5)
U8.5: U8.5 (A3), U10.69 (PJ4)
U8.6: U8.6 (A4), U10.68 (PJ3)
U8.7: U8.7 (A5), U10.67 (PJ2)
U8.8: U8.8 (A6), U10.66 (PJ1)
U8.9: U8.9 (A7), U10.65 (PJ0)
U8.11: J19.21, U8.11 (Y7)
U8.12: J19.19, U8.12 (Y6)
U8.13: J19.17, U8.13 (Y5)
U8.14: J19.15, U8.14 (Y4)
U8.15: J19.11, U8.15 (Y3)
U8.16: J19.9, U8.16 (Y2)
U8.17: J19.7, U8.17 (Y1)
U8.18: J19.5, U8.18 (Y0)
U9.3: U9.3 (A1), U10.82 (PK7)
U9.4: U9.4 (A2), U10.81 (PK6)
U9.5: U9.5 (A3), U10.80 (PK5)
U9.6: U9.6 (A4), U10.79 (PK4)
U9.7: U9.7 (A5), U10.78 (PK3)
U9.8: U9.8 (A6), U10.77 (PK2)
U9.9: U9.9 (A7), U10.76 (PK1)
U9.11: J19.3, U9.11 (Y7)
U9.12: J19.1, U9.12 (Y6)
U9.13: J19.2, U9.13 (Y5)
U9.14: J19.4, U9.14 (Y4)
U9.15: J19.8, U9.15 (Y3)
U9.16: J19.12, U9.16 (Y2)
U9.17: J17.3, U9.17 (Y1)
UARTC0_TX: U6.9 (A7), U10.18 (PC3)
UARTC1_TX: U6.8 (A6), U10.22 (PC7)
UARTD0_TX: U6.7 (A5), U10.28 (PD3)
UARTE0_TX: U6.6 (A4), U10.38 (PE3)
UARTE1_TX: U6.5 (A3), U10.42 (PE7)
UARTF0_TX: U6.4 (A2), U10.48 (PF3)
UARTF1_TX: U6.2 (A0), U6.3 (A1), U10.52 (PF7)
~A_EN: R1.2.1, U1.3.1, U10.87 (PQ2)
~BTN: J19.14, R17.1, U10.85 (PQ0)
~B_EN: R1.10.1, U1.4.1, U10.88 (PQ3)
~OEN: R18.2, U6.1 (G1), U6.19 (G2), U7.1 (G1), U7.19 (G2), U8.1 (G1), U8.19 (G2), U9.1 (G1), U9.19 (G2), U10.75 (PK0)
~UART1_FRONT_EN: R1.9.2, U5.6 (VO2), U10.86 (PQ1)

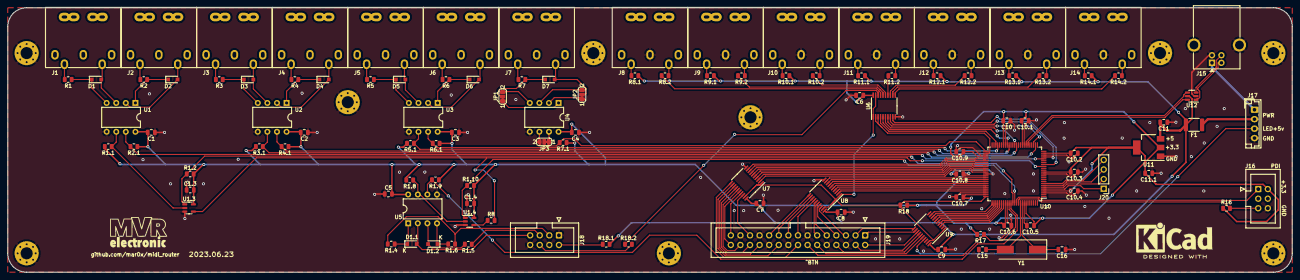
[picture p15: board midi_router_x7_rack.kicad_pcb from above]

Board: 2 copper layers, 340.0 x 70.0 mm, 123 parts (0 on the bottom side), 142 nets.
