mar0x/midi_router/kicad/x2/midi_router.kicad_pcb

## KiCad design kicad/x2/midi_router.kicad_pcb (2022-11-23)

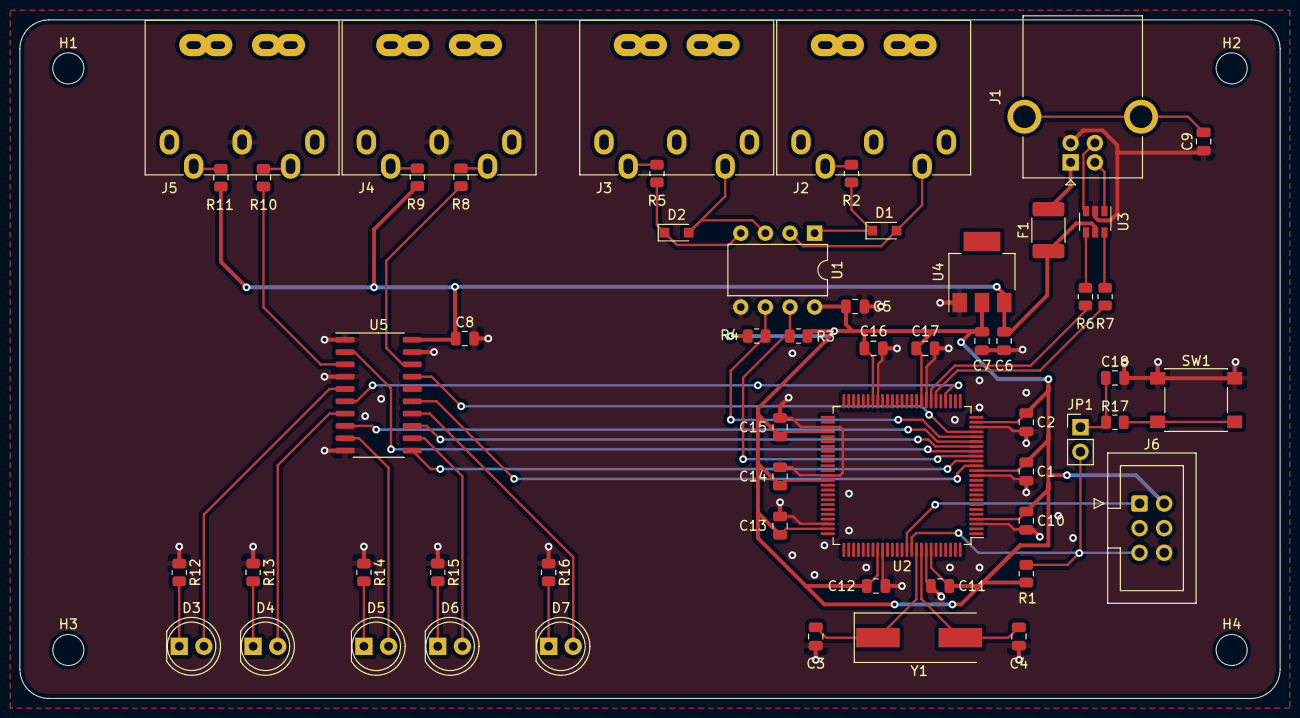
[picture p16: board midi_router.kicad_pcb from above]

Board: 2 copper layers, 130.0 x 70.0 mm, 61 parts (0 on the bottom side), 48 nets.

Parts:
C1, C2, C5, C6, C8, C10, C11, C12, C13, C14, C15, C16, C17, C18: 0.1u; C_0805_2012Metric
C3, C4: 15p; C_0805_2012Metric
C7: 10u; C_0805_2012Metric
C9: 0.01u; C_0805_2012Metric
D1, D2: D; D_SOD-323_HandSoldering
D3, D4, D5, D6, D7: LED; LED_D5.0mm
F1: MF-MSMF050-2; Fuse_1812_4532Metric_Castellated
H1, H2, H3, H4: MountingHole; MountingHole_3.2mm_M3
J1: USB_B; USB_B_OST_USB-B1HSxx_Horizontal
J2, J3, J4, J5: DIN-5_180degree; DIN5MIDI-OOTDTY
J6: Conn_02x03_Odd_Even; IDC-Header_2x03_P2.54mm_Vertical
JP1: Jumper_NO_Small; PinHeader_1x02_P2.54mm_Vertical
R1: 10k; R_0805_2012Metric
R2, R5, R8, R9, R10, R11: 220; R_0805_2012Metric
R3, R4: 470; R_0805_2012Metric
R6, R7: 22; R_0805_2012Metric
R12, R13, R14, R15, R16: 1k; R_0805_2012Metric
R17: 100; R_0805_2012Metric
SW1: SW_Push; SW_Push_1P1T_NO_6x6mm_H9.5mm
U1: HCPL2730; DIP-8_W7.62mm
U2: ATxmega128A1U-AU; TQFP-100_14x14mm_P0.5mm
U3: USBLC6-2SC6; SOT-23-6
U4: LD1117S33TR_SOT223; SOT-223-3_TabPin2
U5: 74HC244; SO-20_5.3x12.6mm_P1.27mm
Y1: 16MHz; Crystal_SMD_HC49-SD

Connections:
+3V3: C1.2, C2.1, C5.1, C7.1, C10.1, C11.1, C12.1, C13.1, C14.1, C15.1, C16.1, C17.1, J6.2, R1.1, R3.1, R4.1, U1.8, U2.4, U2.14, U2.24, U2.34, U2.44, U2.54, U2.64, U2.74, U2.83, U2.94, U4.2
+5V: C6.1, C8.1, F1.1, R9.1, R11.1, U3.5, U4.3, U5.20
D+: R6.1, U2.32
D-: R7.1, U2.31
GND: C1.1, C2.2, C3.1, C4.1, C5.2, C6.2, C7.2, C8.2, C9.1, C10.2, C11.2, C12.2, C13.2, C14.2, C15.2, C16.2, C17.2, C18.2, J1.4, J4.2, J5.2, J6.6, R12.1, R13.1, R14.1, R15.1, R16.1, SW1.1, U1.5, U2.3, U2.13, U2.23, U2.33, U2.43, U2.53, U2.63, U2.73, U2.84, U2.93, U3.2, U4.1, U5.1, U5.4, U5.10, U5.19
unnamed: C3.2, U2.91, Y1.1
unnamed: C4.2, U2.92, Y1.2
unnamed: C9.2, J1.5
unnamed: C18.1, JP1.1, R17.1
unnamed: D1.1, R2.2, U1.1
unnamed: D1.2, J2.5, U1.2
unnamed: D2.1, R5.2, U1.4
unnamed: D2.2, J3.5, U1.3
unnamed: D3.1, R12.2
unnamed: D3.2, U5.5
unnamed: D4.1, R13.2
unnamed: D4.2, U5.7
unnamed: D5.1, R14.2
unnamed: D5.2, U5.9
unnamed: D6.1, R15.2
unnamed: D6.2, U5.12
unnamed: D7.1, R16.2
unnamed: D7.2, U5.14
unnamed: F1.2, J1.1
unnamed: J1.2, U3.1
unnamed: J1.3, U3.3
unnamed: J2.4, R2.1
unnamed: J3.4, R5.1
unnamed: J4.4, R9.2
unnamed: J4.5, R8.1
unnamed: J5.4, R11.2
unnamed: J5.5, R10.1
unnamed: R6.2, U3.4
unnamed: R7.2, U3.6
unnamed: R8.2, U5.18
unnamed: R10.2, U5.3
unnamed: R17.2, SW1.2
PDI_CLK: J6.5, JP1.2, R1.2, U2.90
PDI_DATA: J6.1, U2.89
UARTC_RXD0: R3.2, U1.7, U2.17
UARTC_RXD1: R4.2, U1.6, U2.21
UARTC_SRX0: U2.15, U5.15
UARTC_SRX1: U2.19, U5.13
UARTC_STX0: U2.16, U5.11
UARTC_STX1: U2.20, U5.8
UARTC_TXD0: U2.18, U5.2
UARTC_TXD1: U2.22, U5.17
UARTD_SUSB: U2.29, U5.6
