mar0x/midi_router/kicad/x7-rack/sock/midi_router_x7_sock.kicad_pcb

## KiCad design kicad/x7-rack/sock/midi_router_x7_sock.kicad_pcb (2022-11-08)

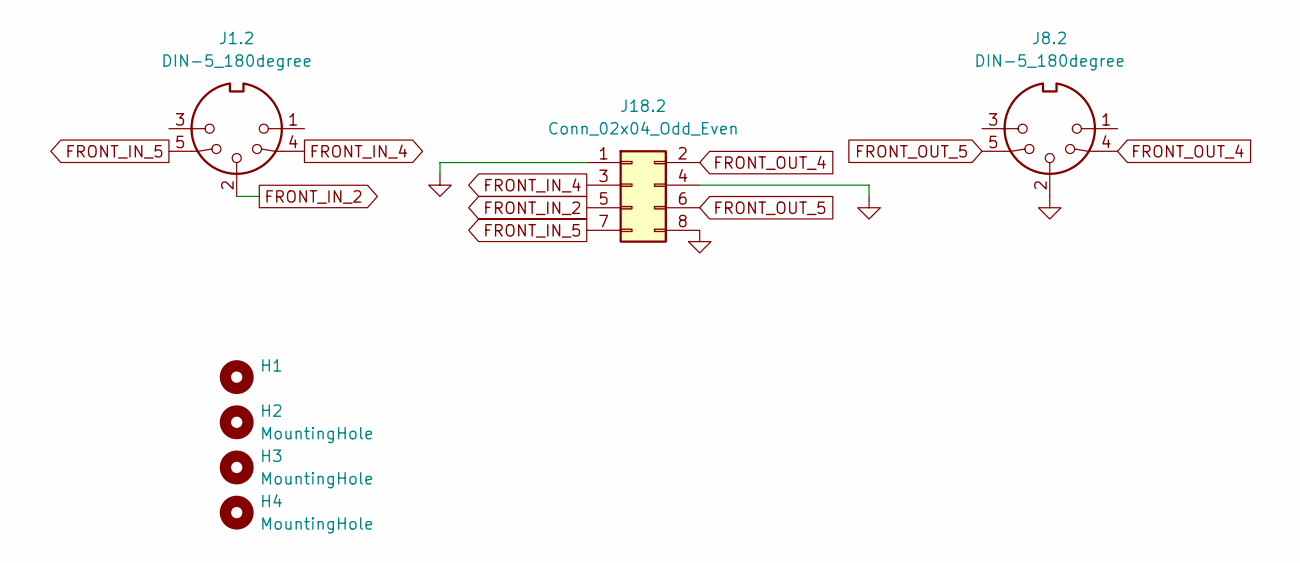
[picture p17: schematic midi_router_x7_sock.kicad_sch]

Parts:
H1: (no value)
H2, H3, H4: MountingHole; MountingHole_3.2mm_M3
J1.2, J8.2: DIN-5_180degree; DIN5MIDI-OOTDTY
J18.2: Conn_02x04_Odd_Even; IDC-Header_2x04_P2.54mm_Vertical

Connections:
FRONT_IN_2: J1.2.2, J18.2.5
FRONT_IN_4: J1.2.4, J18.2.3
FRONT_IN_5: J1.2.5, J18.2.7
FRONT_OUT_4: J8.2.4, J18.2.2
FRONT_OUT_5: J8.2.5, J18.2.6
GND: J8.2.2, J18.2.1, J18.2.4, J18.2.8

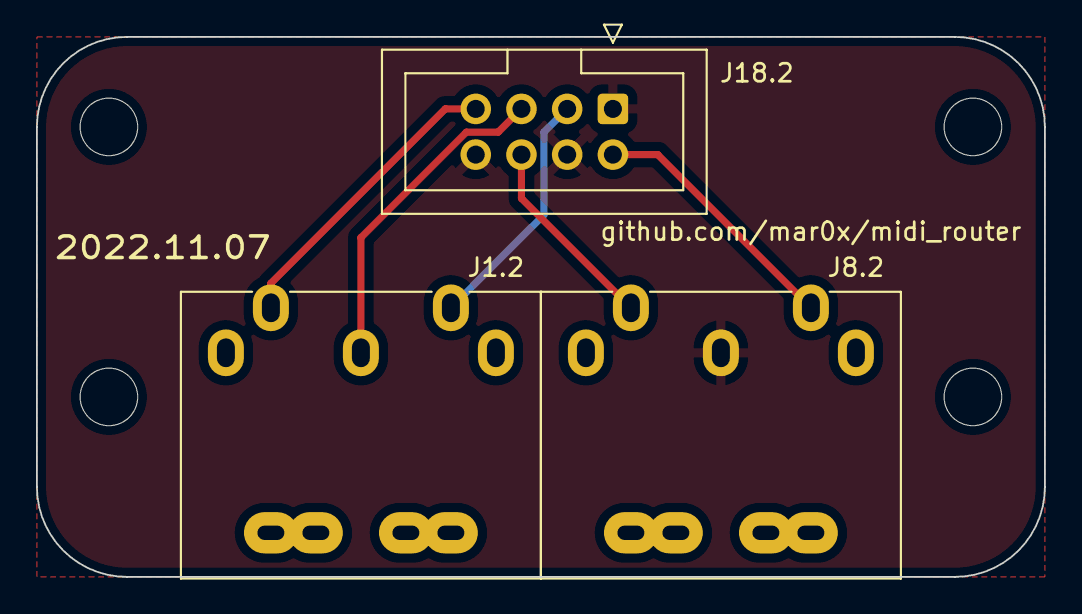
[picture p18: board midi_router_x7_sock.kicad_pcb from above]

Board: 2 copper layers, 56.0 x 30.0 mm, 7 parts (0 on the bottom side), 6 nets.
