mar0x/midi_router/kicad/x4-bottom/usb_midi_x4.kicad_pcb

## KiCad design kicad/x4-bottom/usb_midi_x4.kicad_pcb (2022-03-29)

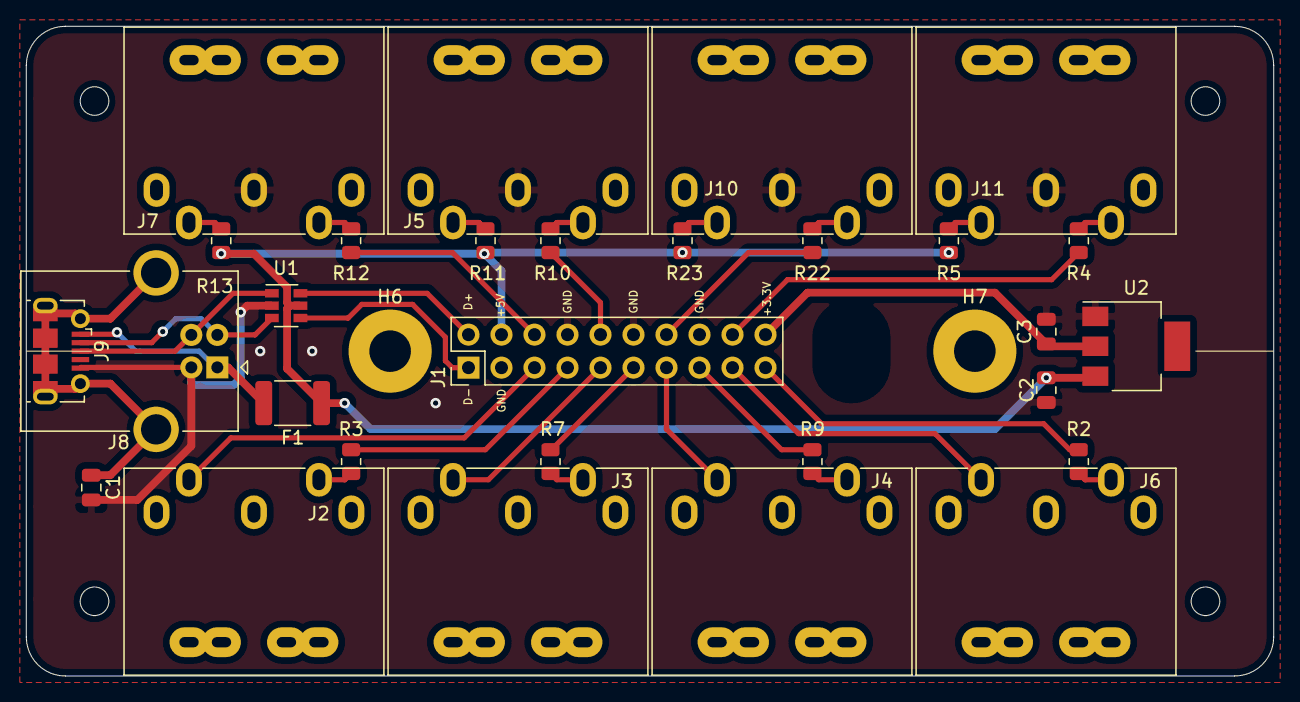
[picture p19: board usb_midi_x4.kicad_pcb from above]

Board: 2 copper layers, 96.0 x 50.0 mm, 35 parts (0 on the bottom side), 33 nets.

Parts:
C1: 10nF; C_0805_2012Metric
C2: 0.1u; C_0805_2012Metric
C3: 10u; C_0805_2012Metric
F1: MF-MSMF050-2; Fuse_1812_4532Metric_Pad1.30x3.40mm_HandSolder
H1, H2, H3, H4: MountingHole; MountingHole_2.2mm_M2_ISO7380
H6, H7: MountingHole; MountingHole_3.2mm_M3_Pad
J1: Conn_02x10_Odd_Even; PinHeader_2x10_P2.54mm_Vertical
J2, J3, J4, J5, J6, J7, J10, J11: DIN-5_180degree; DIN5MIDI-OOTDTY
J8: DS1099; USB_B_OST_USB-B1HSxx_Horizontal
J9: DS1099; USB_Micro-B_Molex-105017-0001
R2, R3, R4, R5, R7, R9, R10, R11, R12, R13, R22, R23: 220; R_0805_2012Metric
U1: USBLC6-2SC6; SOT-23-6
U2: LD1117S33TR_SOT223; SOT-223-3_TabPin2

Connections:
+3V3: C3.1, J1.20, U2.2
+5V: C2.1, F1.1, J1.4, R5.1, R11.1, R13.1, R23.1, U1.5, U2.3
D+: J8.3, J9.3, U1.1
D-: J8.2, J9.2, U1.3
GND: C1.2, C2.2, C3.2, J1.3, J1.8, J1.12, J1.16, J5.2, J7.2, J8.4, J9.5, J10.2, J11.2, U1.2, U2.1
IN1_5V: J1.7, R3.1
IN1_D: J1.5, J2.5
IN2_5V: J1.11, R7.1
IN2_D: J1.9, J3.5
IN3_5V: J1.15, R9.1
IN3_D: J1.13, J4.5
IN4_5V: J1.19, R2.1
IN4_D: J1.17, J6.5
unnamed: J2.4, R3.2
unnamed: J3.4, R7.2
unnamed: J4.4, R9.2
unnamed: J5.4, R11.2
unnamed: J5.5, R10.1
unnamed: J6.4, R2.2
unnamed: J7.4, R13.2
unnamed: J7.5, R12.1
unnamed: J10.4, R23.2
unnamed: J10.5, R22.1
unnamed: J11.4, R5.2
unnamed: J11.5, R4.1
OD+: J1.2, U1.6
OD-: J1.1, U1.4
OUT1: J1.18, R4.2
OUT2: J1.14, R22.2
OUT3: J1.10, R10.2
OUT4: J1.6, R12.2
SHLD: C1.1, J8.5, J9.6
VBUS: F1.2, J8.1, J9.1
