mar0x/midi_router/firmware/asf-3.50.0/common/services/clock/xmega/osc.h

/**
 * \file
 *
 * \brief Chip-specific oscillator management functions
 *
 * Copyright (c) 2010-2018 Microchip Technology Inc. and its subsidiaries.
 *
 * \asf_license_start
 *
 * \page License
 *
 * Subject to your compliance with these terms, you may use Microchip
 * software and any derivatives exclusively with Microchip products.
 * It is your responsibility to comply with third party license terms applicable
 * to your use of third party software (including open source software) that
 * may accompany Microchip software.
 *
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
 * \asf_license_stop
 *
 */
/*
 * Support and FAQ: visit <a href="https://www.microchip.com/support/">Microchip Support</a>
 */
#ifndef XMEGA_OSC_H_INCLUDED
#define XMEGA_OSC_H_INCLUDED

#include <compiler.h>
#include <board.h>

/**
 * \weakgroup osc_group
 *
 * \section osc_group_errata Errata
 *   - Auto-calibration does not work on XMEGA A1 revision H and
 *     earlier.
 * @{
 */

//! \name Oscillator identifiers
//@{
//! 2 MHz Internal RC Oscillator
#define OSC_ID_RC2MHZ         OSC_RC2MEN_bm
//! 32 MHz Internal RC Oscillator
#define OSC_ID_RC32MHZ        OSC_RC32MEN_bm
//! 32 KHz Internal RC Oscillator
#define OSC_ID_RC32KHZ        OSC_RC32KEN_bm
//! External Oscillator
#define OSC_ID_XOSC           OSC_XOSCEN_bm
#if XMEGA_E
//! 8 MHz Internal RC Oscillator
# define OSC_ID_RC8MHZ        OSC_RC8MEN_bm
#endif
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
