mar0x/midi_router/(commit log)

2021-07-27 USB MIDI Router.
    AVR xmega based device to add multiple "classic" MIDI ports in PC via USB.
    [MIDI-Lab-1-Extrude.step, midi_router-bom.xlsx, midi_router.kicad_pcb, midi_router.sch, midi_router_x7.kicad_pcb, midi_router_x7.sch, usb_midi_x4.csv, usb_midi_x4.kicad_pcb]
2021-07-27 x2 prototype: fixing MIDI out connection.
    [midi_router.kicad_pcb, midi_router.sch]
2021-07-27 x7: updating MIDI connector 3D model.
    [midi_router_x7.kicad_pcb]
2021-07-29 Minor tracing fixes.
    [midi_router_x7.kicad_pcb]
2021-10-21 Bootloaders adjusted to boards and MCUs.
2021-10-21 Enable drivers.
2021-11-13 Box improvements.
    - fixed error (0.5mm) in board position calculation;
    - removed bottom enforcement;
    - parametric led shape;
2021-11-13 Updating BOM.
    [midi_router-bom.xlsx]
2021-11-13 Timer interrupt level changed to MEDIUM to avoid splitter delays.
    [timer.cpp]
2021-11-13 Store and restore flags in pin change interrupts.
2021-12-04 Changing timer interrupt level once again.
2021-12-08 Improving performance.
    - introducing stats;
    - removing serial RX buffers;
    - tweaking leds;
2021-12-10 Updating USB transfer error count.
    [main.cpp]
2021-12-11 Adding rst button hole.
2021-12-28 Fixing MIDI command extraction.
    For some SysEx data command() may return non-zero which lead to skip
    MIDI event by USB stack. Affects only MIDI->USB data pass.
    [midi_cmd.h]
2021-12-28 Updating components.
    [midi_router-bom.xlsx, midi_router_x7.sch]
2022-03-13 Updating BOM and router schemas.
    [midi_router-bom.xlsx]
2022-03-22 Adjusting x2 led output.
2022-03-29 Minor tweaks.
    [midi_router-bom.xlsx, midi_router_x7.kicad_pcb, midi_router_x7.sch, usb_midi_x4.kicad_pcb, usb_midi_x4_top.kicad_pcb, usb_midi_x4_top.sch]
2022-04-10 Updating MIDI socket 3D model.
2022-04-10 Introducing x4 flat board.
    [midi_router_x4.kicad_pcb, midi_router_x4.kicad_sch]
2022-07-15 4x4 flat: fixing incoming port for spliiter mode.
    [midi.cpp, version.h]
2022-07-15 4x4-flat: making box 4mm lower.
2022-07-28 Making box 1mm lower.
2022-08-23 7x7: making box 5mm lower.
2022-11-01 Introducing command normalizer.
    Normalizer aimed to restore the MIDI command "optimized" by some
    MIDI keyboards (notable "Samson Carbon 61", "Yamaha MM6").
    Where "optimize" means skip the MIDI command "Note On" or "Note Off"
    byte and send only it's parameters.
    "Samson Carbon 61" optimizes only frequently repeating events while
    "Yamaha MM6" do it more "aggresively".
    [cdc_print.h, conf_usb.h, main.cpp, midi.cpp, midi.h, midi_cmd.h, midi_normalizer.h, serial_cmd.h]
2022-11-08 Introducing MIDI Router x7 Rack.
    Schematic and PCBs.
    [midi_router_x7_led.kicad_pcb, midi_router_x7_led.kicad_sch, midi_router_x7_rack.kicad_pcb, midi_router_x7_rack.kicad_sch, midi_router_x7_sock.kicad_pcb, midi_router_x7_sock.kicad_sch]
2022-11-08 Rack case front and back drawings.
2022-11-23 Accidental changes
    [midi_router.kicad_pcb, midi_router_x7_led.kicad_pcb]
2023-01-03 MIDI Router x7 Rack: fixing pin mapping
    [ui.cpp]
2023-06-23 Fixing main board issues
    - box to ground connection
    - RX1 connection
    [midi_router_x7_rack.kicad_pcb, midi_router_x7_rack.kicad_sch]
2023-06-23 Updating KiCAD
    [midi_router_x7_rack.kicad_pcb, midi_router_x7_rack.kicad_sch]
2023-07-06 Sync state with LED
2024-06-15 Add atxmega32a4u mini board
2024-06-15 Version update
    [midi_router-bom.xlsx, midi_router_x7_led.kicad_pcb, midi_router_x7_led.kicad_sch, midi_router_x7_rack.kicad_pcb]
2024-06-15 x4 KiCad upgrade
    [midi_router_x4.kicad_pcb, midi_router_x4.kicad_sch]
2024-06-15 x7 KiCad upgrade
    [midi_router_x7.kicad_pcb, midi_router_x7.kicad_sch, midi_router_x7.sch]
2024-06-15 x4-top KiCad upgrade
    [usb_midi_x4_top.csv, usb_midi_x4_top.kicad_pcb, usb_midi_x4_top.kicad_sch, usb_midi_x4_top.sch]
